tone-3000/nam-pedal/hardware/enclosure/face-drill.pdf

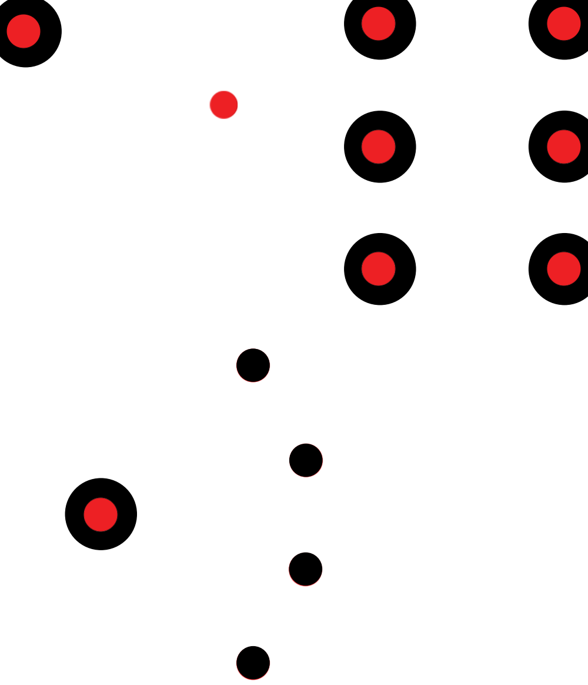
[picture p10: figure]
