tone-3000/nam-pedal/app/src/assets/pedal/bezel-off.webp

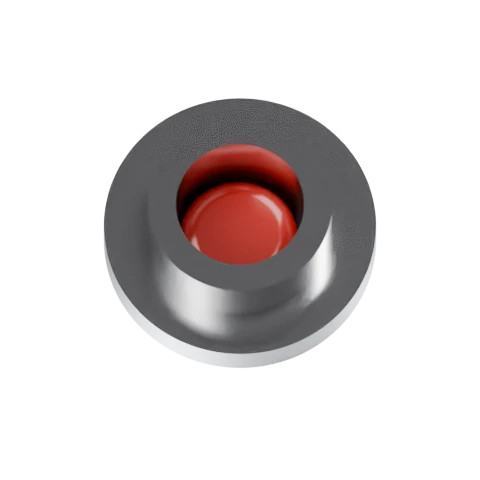
app/src/assets/pedal/bezel-off.webp
