tone-3000/nam-pedal/app/src/assets/pedal/bezel-on.webp

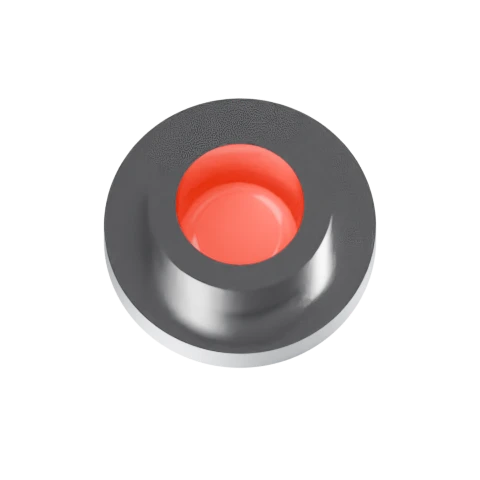
app/src/assets/pedal/bezel-on.webp
