tone-3000/nam-pedal/app/src/assets/pedal/knob.webp

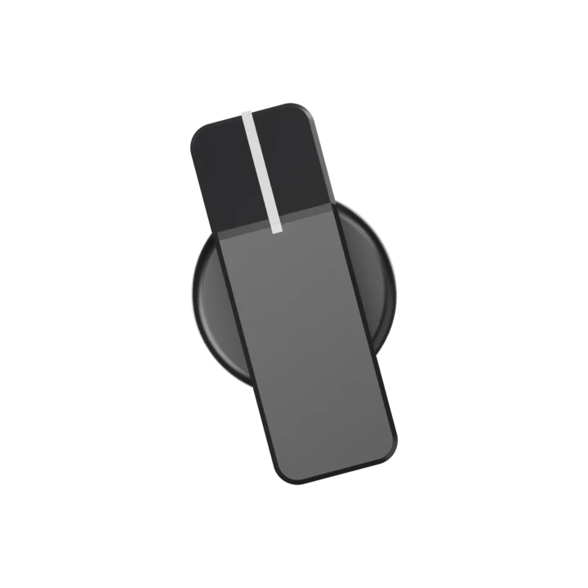
app/src/assets/pedal/knob.webp
