tone-3000/nam-pedal/hardware/enclosure/face-artwork.png

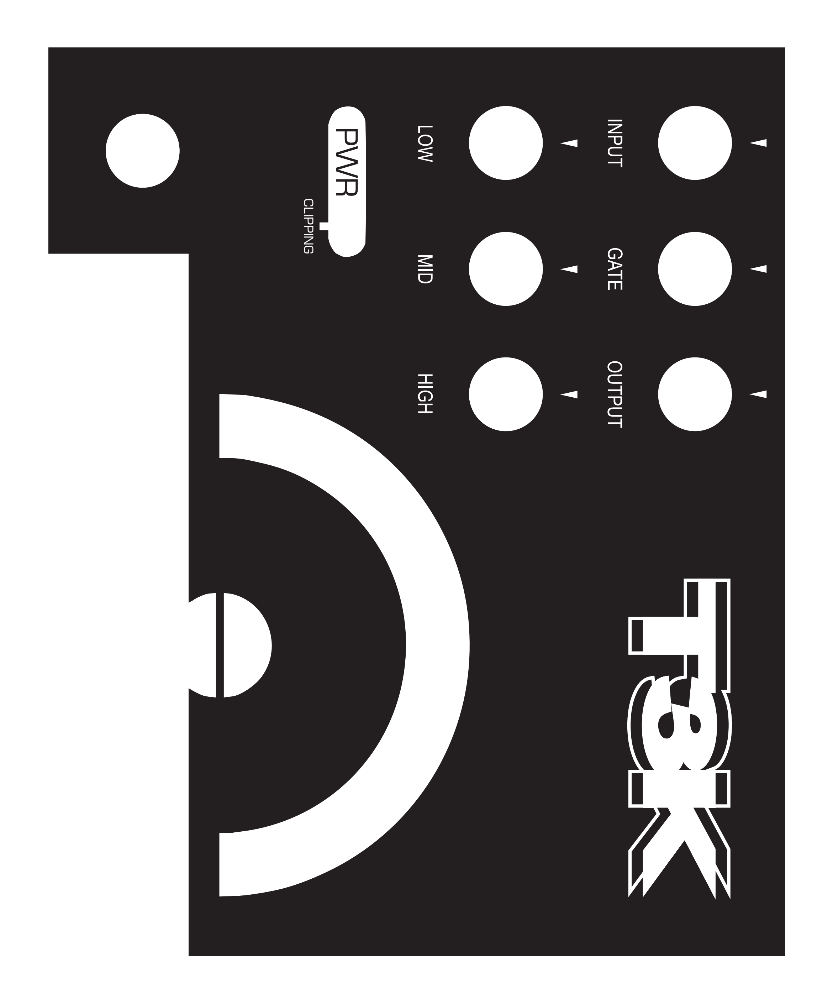
hardware/enclosure/face-artwork.png
