tone-3000/nam-pedal/hardware/enclosure/face-drill.png

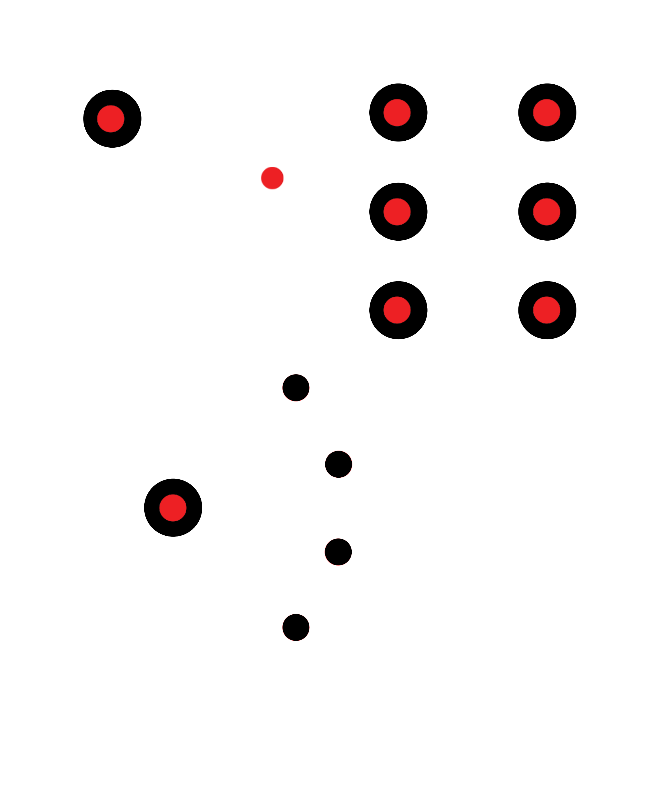
hardware/enclosure/face-drill.png
