tone-3000/nam-pedal/hardware/enclosure/side-wordmark.png

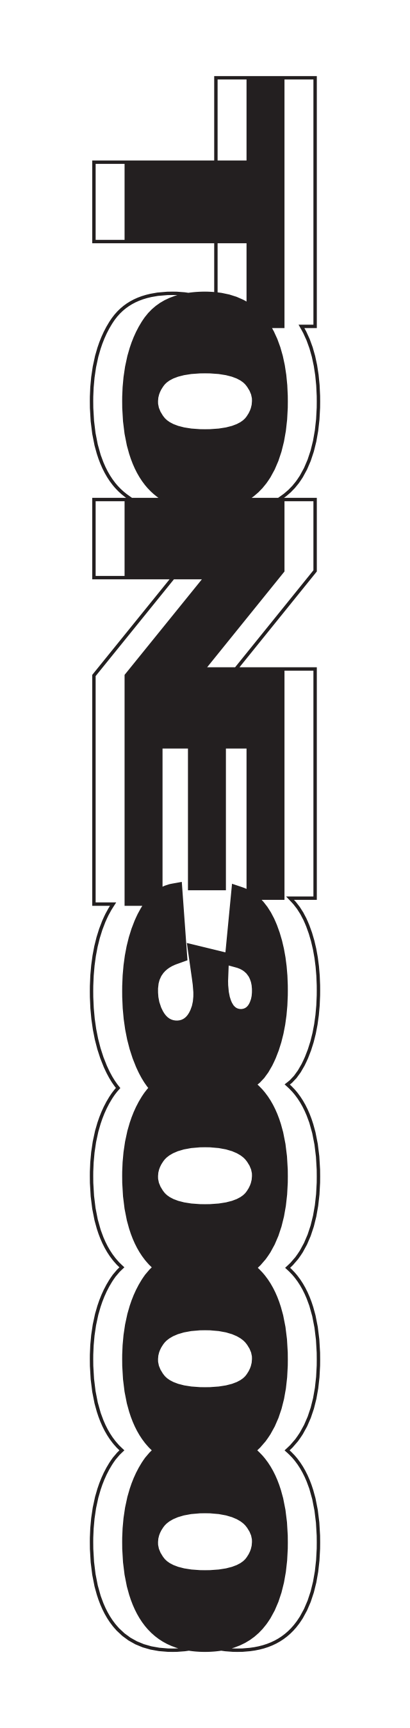
hardware/enclosure/side-wordmark.png
