tone-3000/nam-pedal/hardware/pcb/images/pcb-render-bottom.jpg

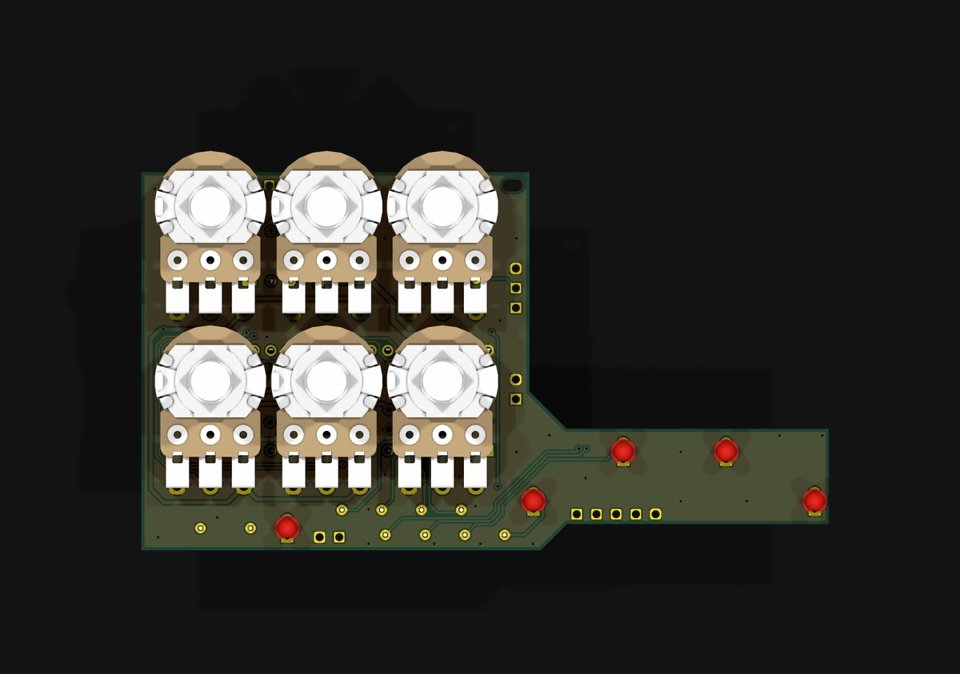
hardware/pcb/images/pcb-render-bottom.jpg
