tone-3000/nam-pedal/hardware/pcb/images/pcb-render-iso.jpg

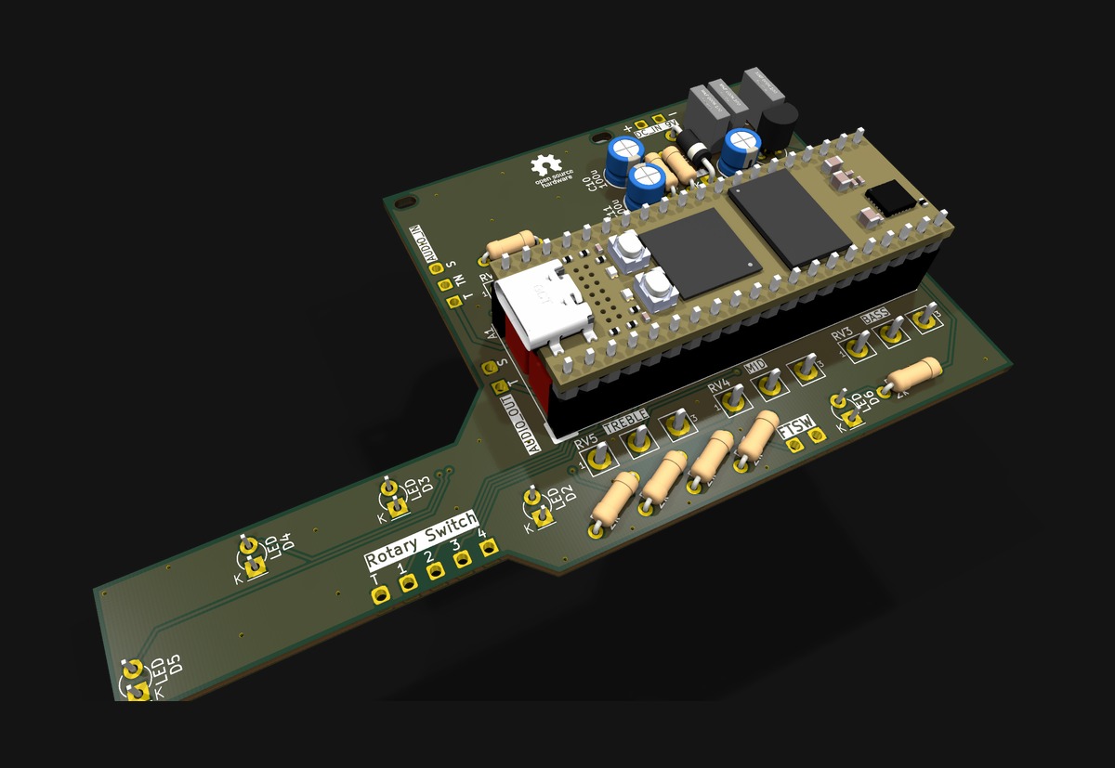
hardware/pcb/images/pcb-render-iso.jpg
