tone-3000/nam-pedal/hardware/pcb/images/pcb-render-top.jpg

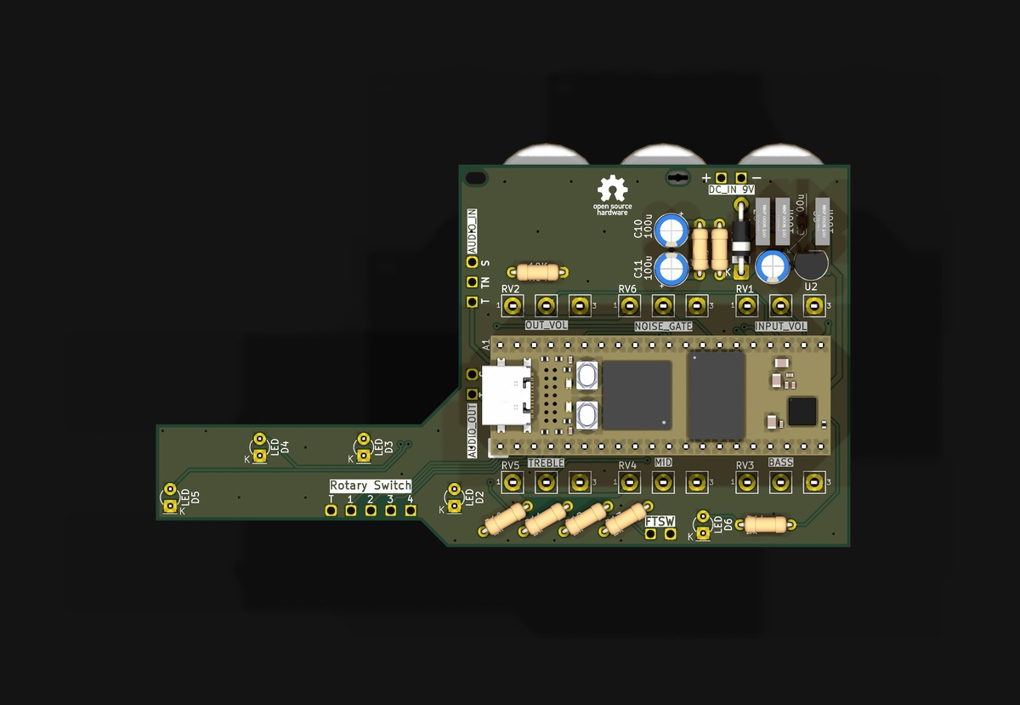
hardware/pcb/images/pcb-render-top.jpg
