tone-3000/nam-pedal/hardware/renders/card-pedal-and-pcb.jpg

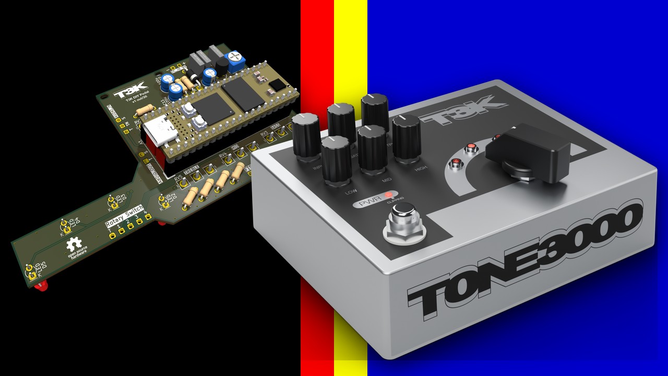
hardware/renders/card-pedal-and-pcb.jpg
