tone-3000/nam-pedal/hardware/renders/pcb-stage-s0-bare.jpg

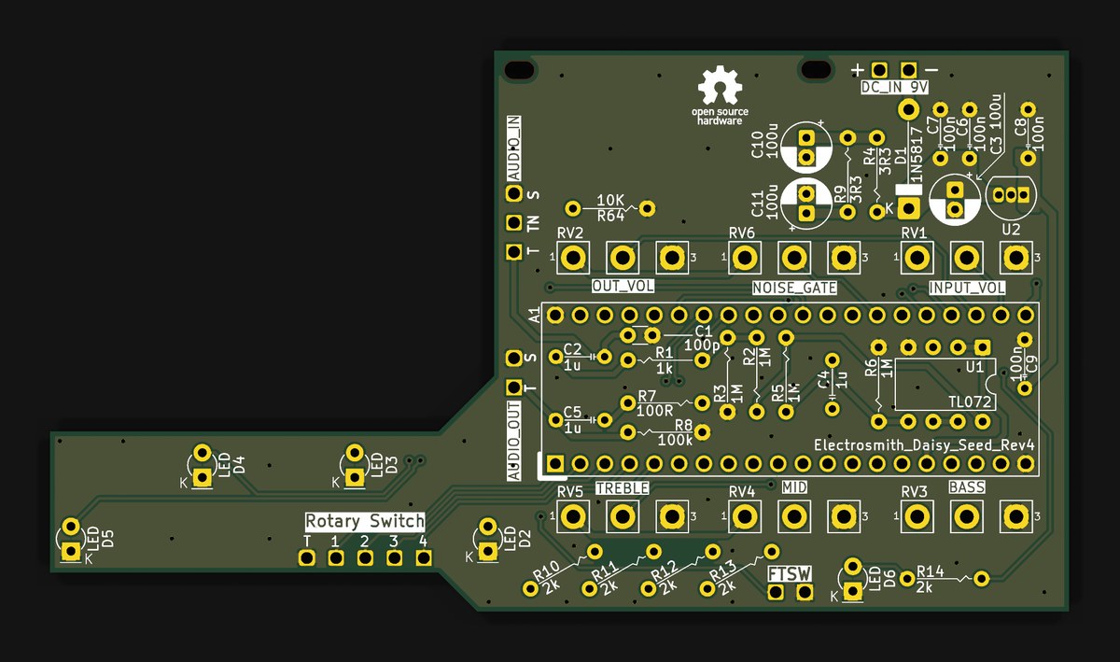
hardware/renders/pcb-stage-s0-bare.jpg
