tone-3000/nam-pedal/hardware/renders/pcb-stage-s1-resistors.jpg

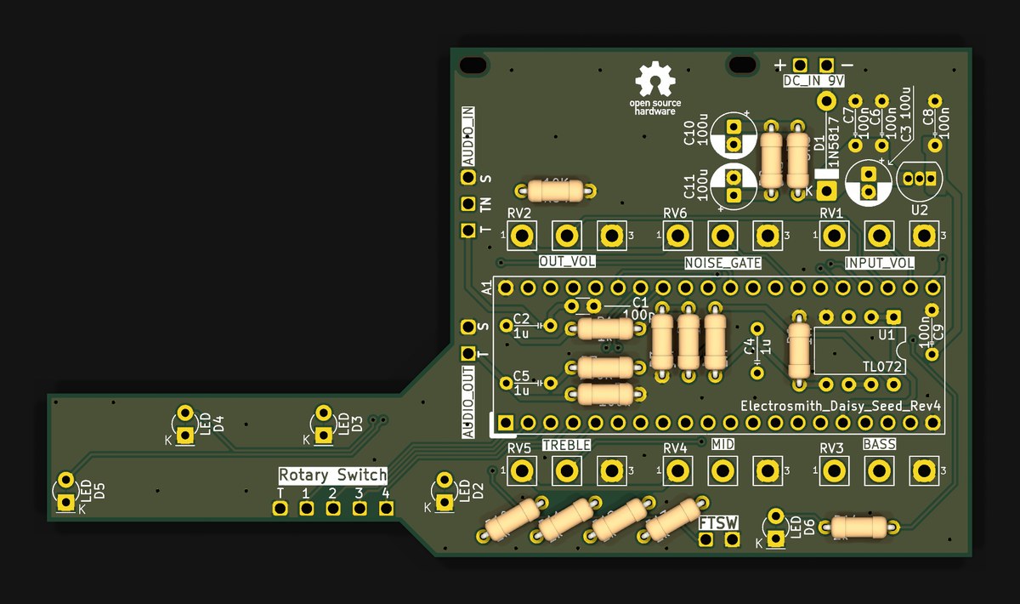
hardware/renders/pcb-stage-s1-resistors.jpg
