tone-3000/nam-pedal/hardware/renders/pcb-stage-s3-caps.jpg

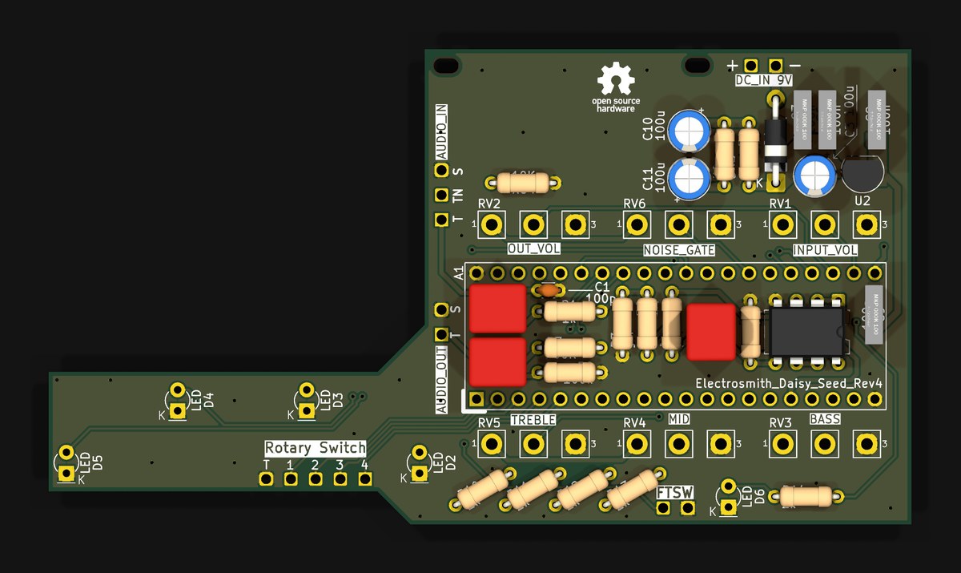
hardware/renders/pcb-stage-s3-caps.jpg
