tone-3000/nam-pedal/hardware/renders/pcb-stage-s5-controls.jpg

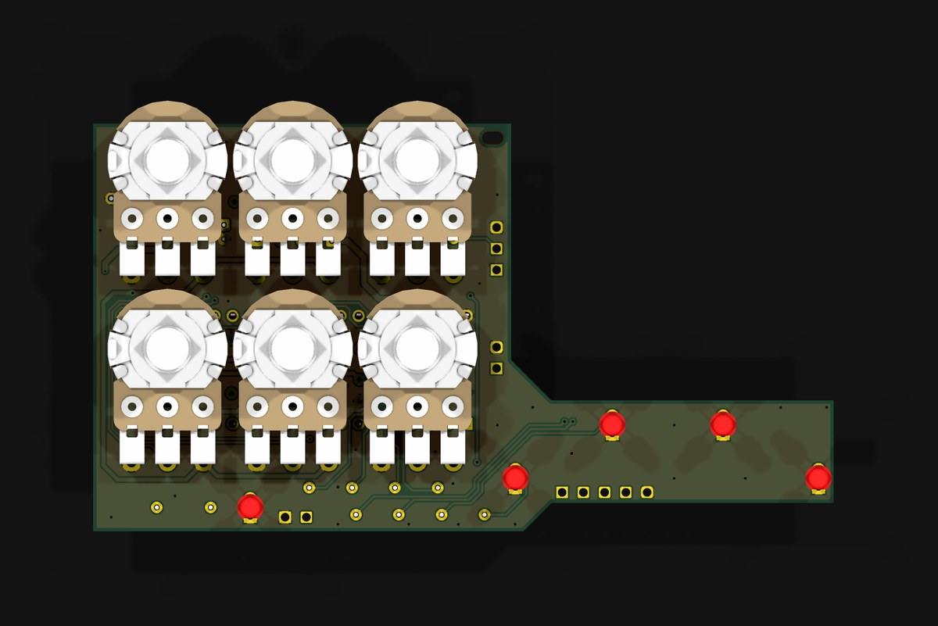
hardware/renders/pcb-stage-s5-controls.jpg
