tone-3000/nam-pedal/hardware/renders/pcb-stage-s6-full-iso.jpg

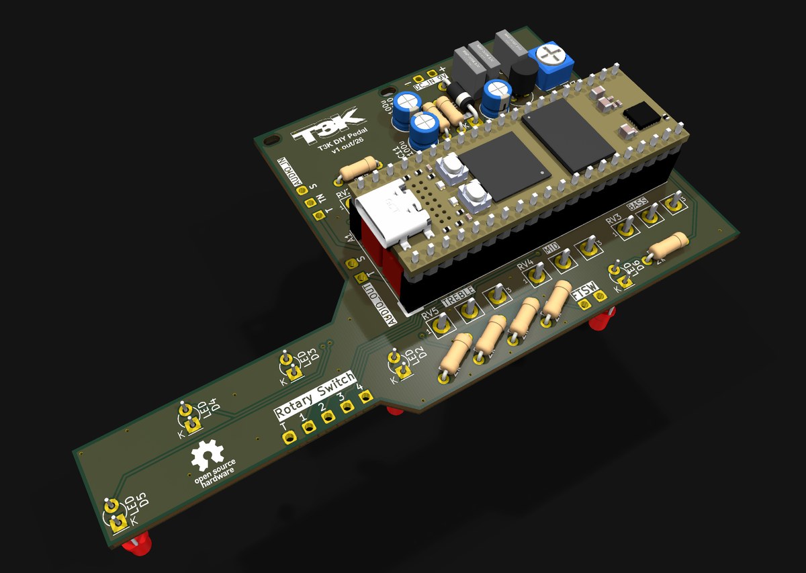
hardware/renders/pcb-stage-s6-full-iso.jpg
