tone-3000/nam-pedal/hardware/renders/pedal-hero.jpg

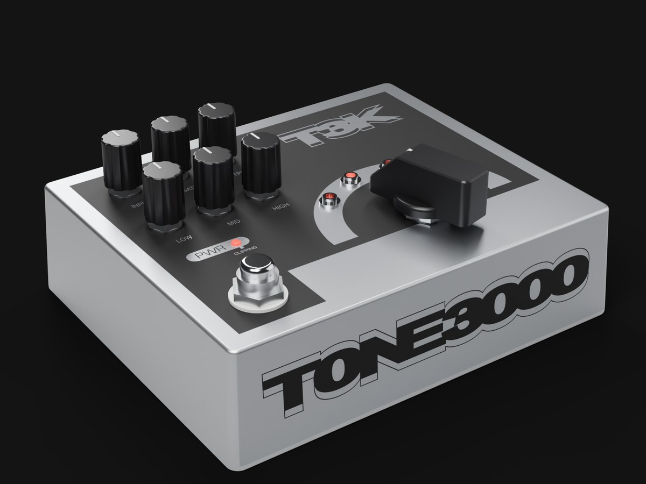
hardware/renders/pedal-hero.jpg
