tone-3000/nam-pedal/hardware/renders/pedal-iso-2.jpg

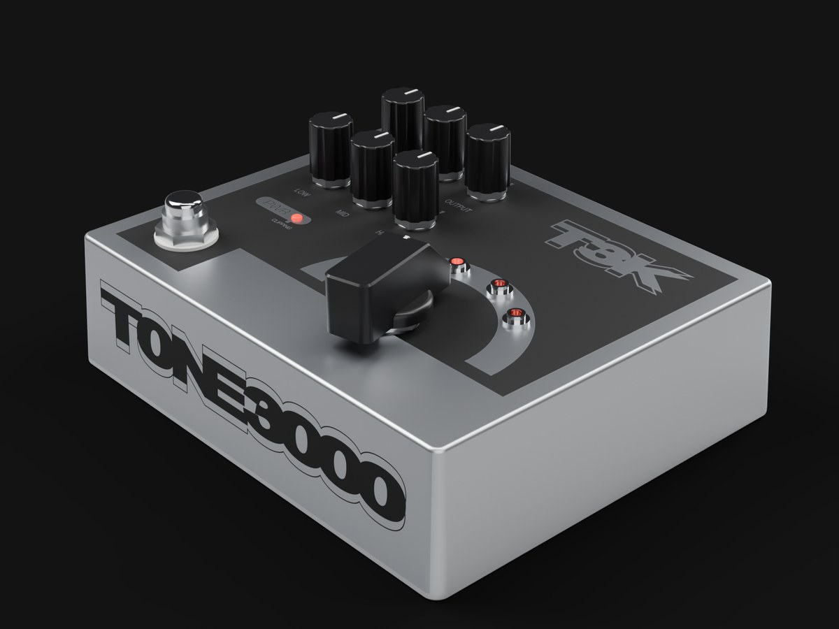
hardware/renders/pedal-iso-2.jpg
