tone-3000/nam-pedal/hardware/renders/src/textures/face_base.png

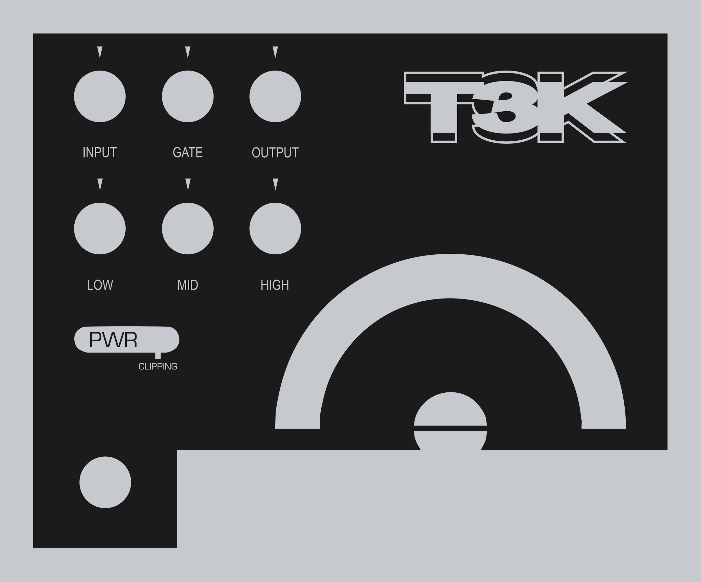
hardware/renders/src/textures/face_base.png
