tone-3000/nam-pedal/hardware/renders/src/textures/face_mr.png

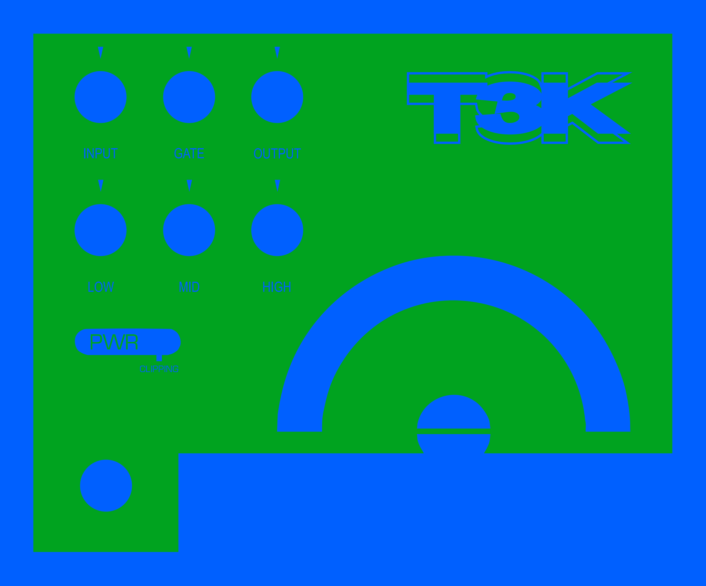
hardware/renders/src/textures/face_mr.png
