tone-3000/nam-pedal/hardware/renders/src/textures/side_base.png

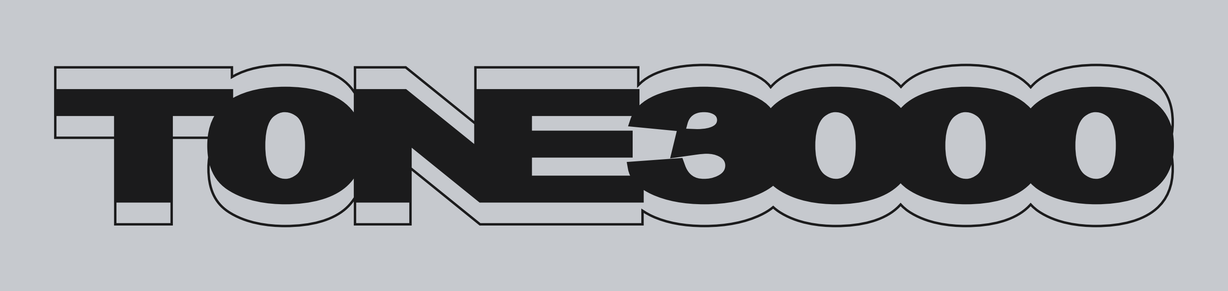
hardware/renders/src/textures/side_base.png
