tone-3000/nam-pedal/hardware/renders/src/textures/side_mr.png

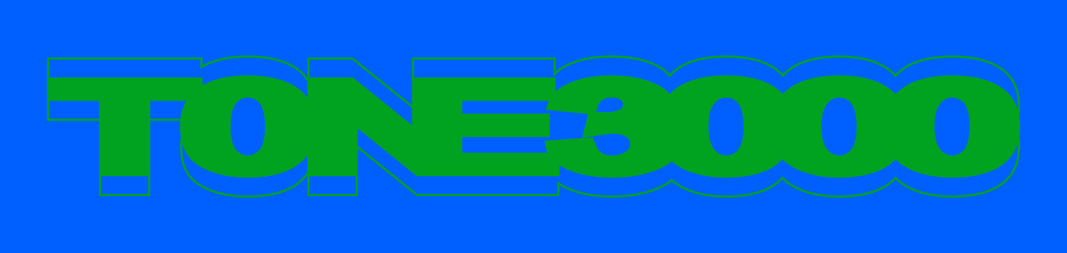
hardware/renders/src/textures/side_mr.png
