tone-3000/nam-pedal/hardware/pcb/bom-kicad.csv

Reference | Value | Footprint | Qty
A1 | Electrosmith_Daisy_Seed_Rev4 | Module:Electrosmith_Daisy_Seed | 1
C1 | 100p | Capacitor_THT:C_Disc_D3.0mm_W1.6mm_P2.50mm | 1
C2,C4,C5 | 1u | Capacitor_THT:C_Rect_L7.2mm_W6.0mm_P5.00mm | 3
C3,C10,C11 | 100u | Capacitor_THT:CP_Radial_D5.0mm_P2.00mm | 3
C6-C9 | 100n | Capacitor_THT:C_Rect_L7.2mm_W2.5mm_P5.00mm | 4
D1 | 1N5817 | Diode_THT:D_DO-41_SOD81_P10.16mm_Horizontal | 1
D2-D6 | LED | LED_THT:LED_D3.0mm_reverse | 5
J2 | JACK_TRS_SWITCHING | Connector_Audio:3T 6.35mm 14 Stereo Chassis Socket | 1
J3 | JACK_TRS_SWITCHING | Connector_Audio:2T 6.35mm 14 Stereo Chassis Socket | 1
J8 | Barrel_Jack_Switch | Connector_Pin:2 Pin DC Jack Chassis mount connector | 1
R1 | 1k | Resistor_THT:R_Axial_DIN0207_L6.3mm_D2.5mm_P7.62mm_Horizontal | 1
R2,R3,R5,R6 | 1M | Resistor_THT:R_Axial_DIN0207_L6.3mm_D2.5mm_P7.62mm_Horizontal | 4
R4,R9 | 3R3 | Resistor_THT:R_Axial_DIN0207_L6.3mm_D2.5mm_P7.62mm_Horizontal | 2
R7 | 100R | Resistor_THT:R_Axial_DIN0207_L6.3mm_D2.5mm_P7.62mm_Horizontal | 1
R8 | 100k | Resistor_THT:R_Axial_DIN0207_L6.3mm_D2.5mm_P7.62mm_Horizontal | 1
R10-R14 | 2k | Resistor_THT:R_Axial_DIN0207_L6.3mm_D2.5mm_P7.62mm_Horizontal | 5
R64 | 10K | Resistor_THT:R_Axial_DIN0207_L6.3mm_D2.5mm_P7.62mm_Horizontal | 1
RV1-RV6 | B10k | Library:POT_16MM | 6
RV7 | 10k | Potentiometer_THT:Potentiometer_Runtron_RM-065_Vertical | 1
SW1 | SW_Rotary_1x4_MP | Connector_Pin:Rotary Switch 3 Pole 4 Position ALPHA SR2511F | 1
SW2 | SW_Push_SPDT | Connector_Pin:2 Pin FTSW | 1
U1 | TL072 | Package_DIP:DIP-8_W7.62mm | 1
U2 | LM78L05_TO92 | Package_TO_SOT_THT:TO-92_Inline | 1
