tone-3000/nam-pedal/hardware/pcb/3d-models/header_2.54_female.stp

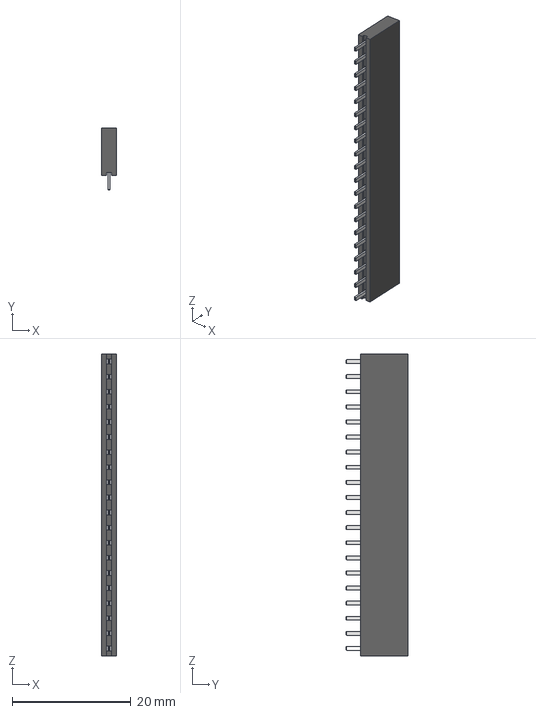
[picture p32: CAD file, 2026-10-20]
hardware/pcb/3d-models/header_2.54_female.stp
2.50 x 10.5 x 50.8 mm
