tone-3000/nam-pedal/hardware/pcb/3d-models/LED_D3.0mm_FlatTop_Standoff10.step

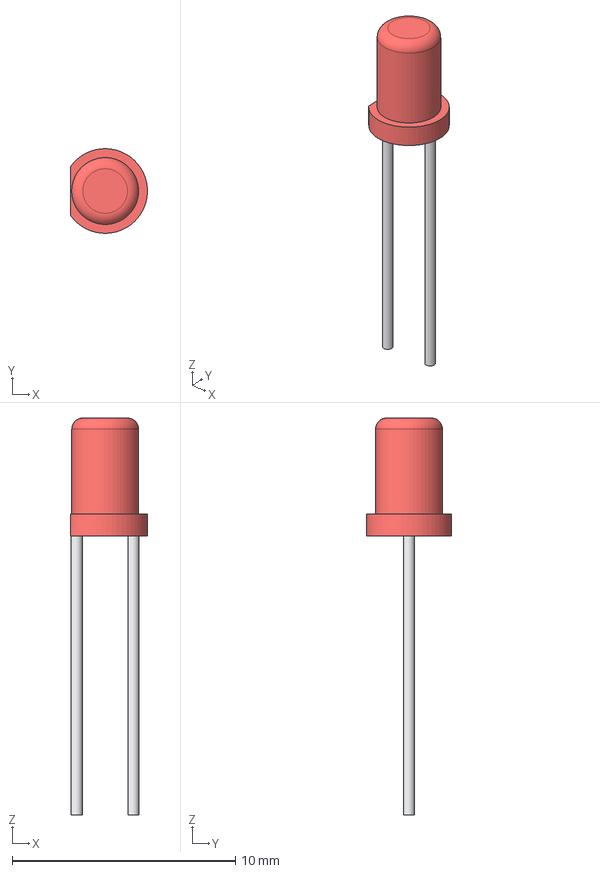
[picture p33: CAD file, 2026-10-20]
hardware/pcb/3d-models/LED_D3.0mm_FlatTop_Standoff10.step
3.45 x 3.80 x 17.8 mm
lens
legs
