tone-3000/nam-pedal/hardware/pcb/3d-models/ES_Daisy_Seed3_Rev5.step

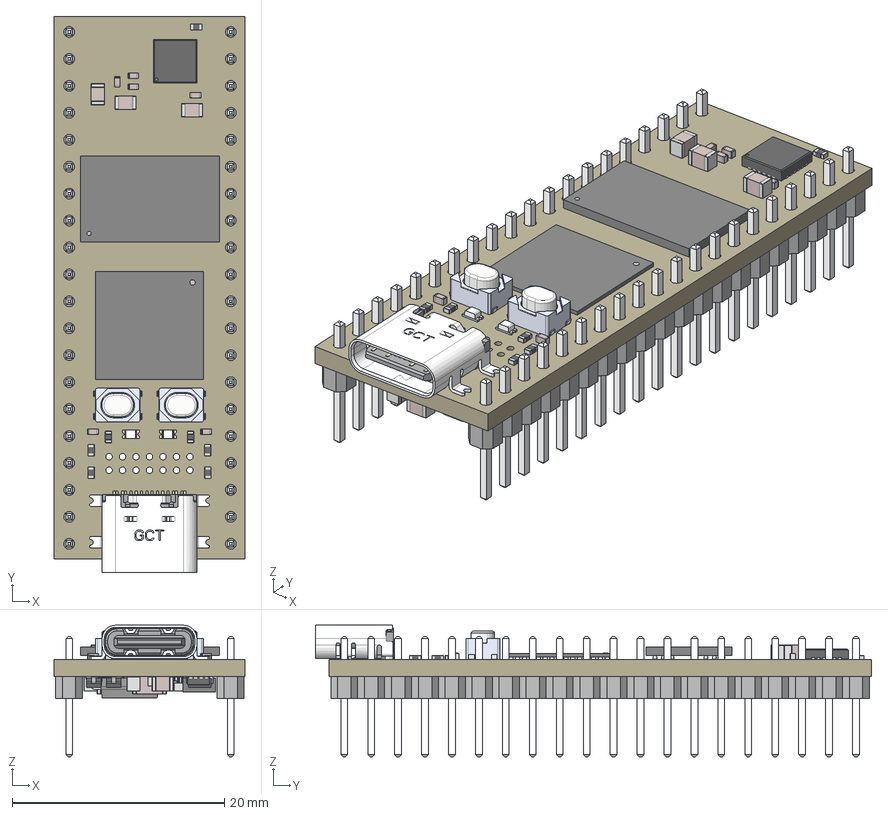
[picture p34: CAD file, 2026-10-20]
hardware/pcb/3d-models/ES_Daisy_Seed3_Rev5.step
18.0 x 52.4 x 12.4 mm
Board
VQFN24_RGE_CORNERPADS_TEX
1X20_NO_SILK_SQR
1X20_NO_SILK
FBGA-90_CLEAN-POL
UFBGA-176_CLEAN-POL
WSON-8-TI
DIODE_0603 x 2
PTS815 x 2
BOURNS_SRP2010
CAPC1005X61N x 46
CAPC2012X137N x 12
CAPC3116X163N x 2
OSCSC320X250X100N
R0402 x 15
YAG-FB-0603-1608
YAG-FB-0603-1608 (1)
SOT23-5
SOD2512X100N x 2
SOT-23-6L
USB4110-GF-A_revB(1) MF
