tone-3000/nam-pedal/hardware/pcb/3d-models/Trimmer_RM-065_Vertical.step

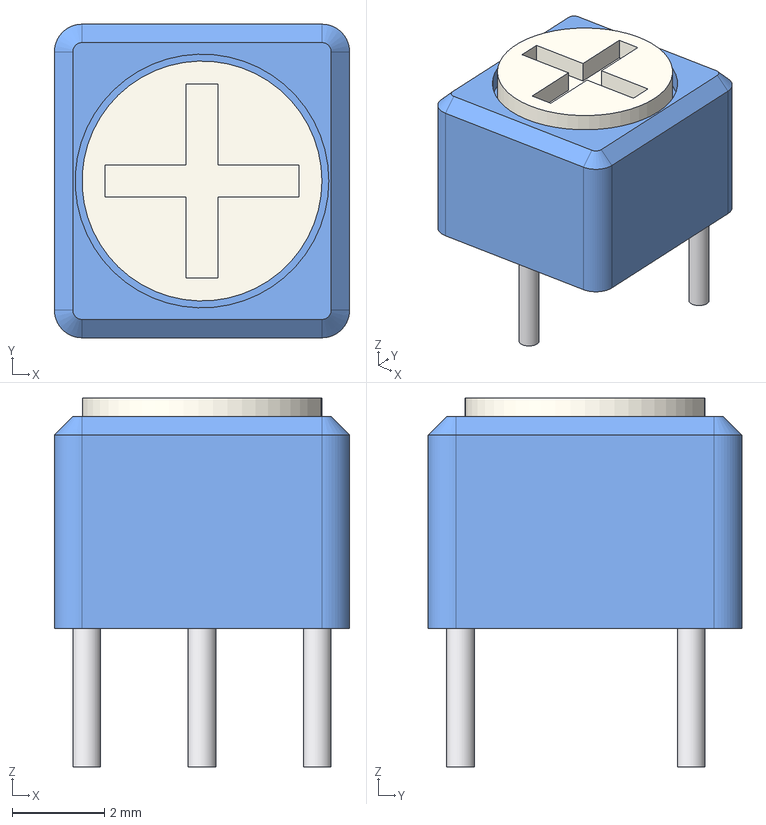
[picture p35: CAD file, 2026-10-20]
hardware/pcb/3d-models/Trimmer_RM-065_Vertical.step
6.40 x 6.80 x 8.00 mm
rotor
legs
