tone-3000/nam-pedal/hardware/pcb/3d-models/RV16AF-41.step

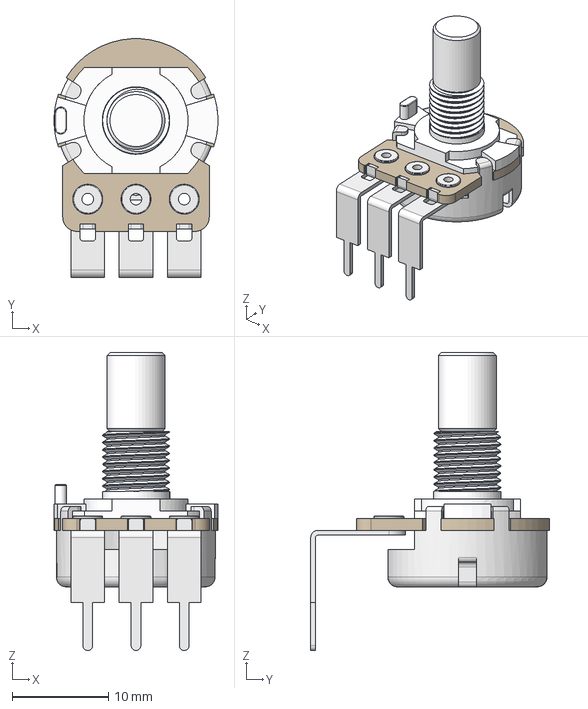
[picture p36: CAD file, 2026-10-20]
hardware/pcb/3d-models/RV16AF-41.step
17.0 x 24.7 x 30.9 mm
