tone-3000/nam-pedal/hardware/pcb/3d-models/User Library-Cap-5 (7_2x6_5x2_2)Dark.step

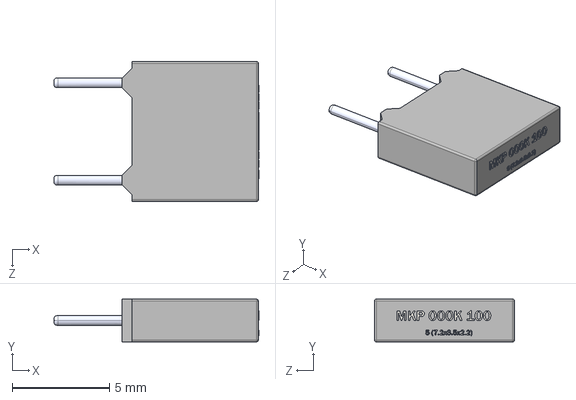
[picture p37: CAD file, 2026-10-20]
hardware/pcb/3d-models/User Library-Cap-5 (7_2x6_5x2_2)Dark.step
10.5 x 2.20 x 7.20 mm
