tone-3000/nam-pedal/hardware/renders/build-06-hardware-top.jpg

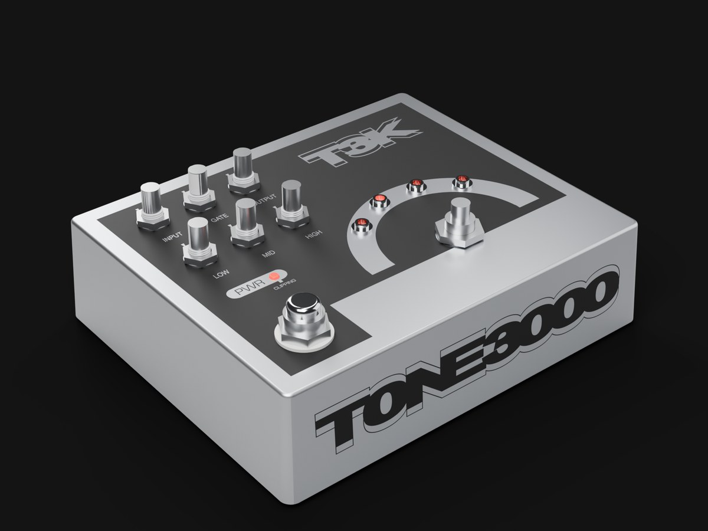
hardware/renders/build-06-hardware-top.jpg
