tone-3000/nam-pedal/hardware/renders/build-07-wiring-jacks.jpg

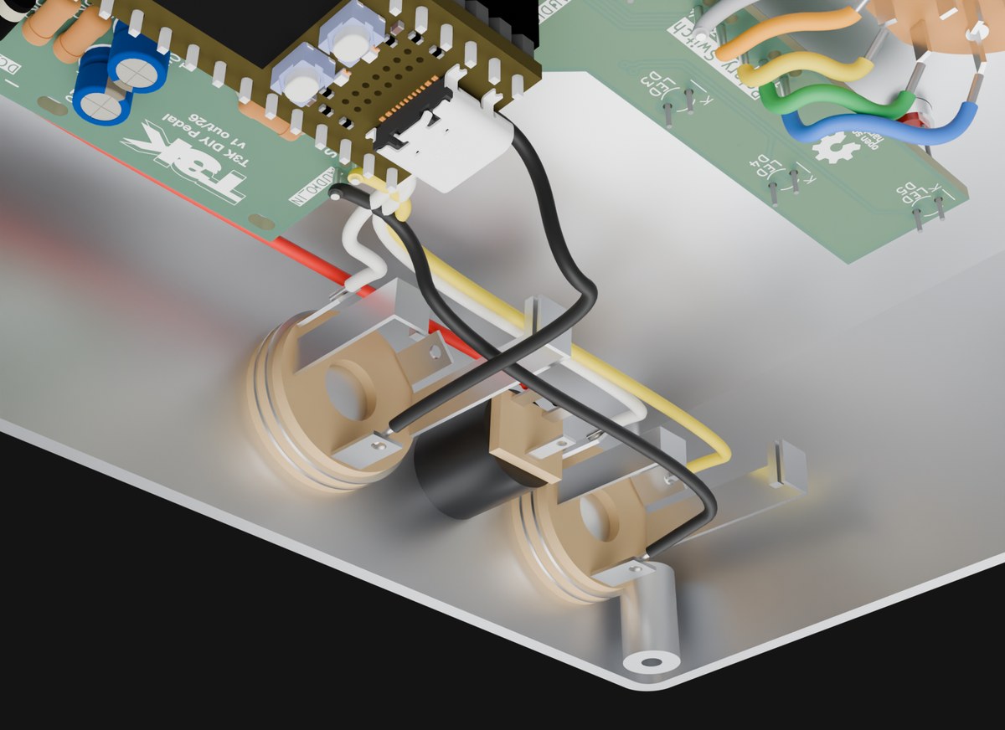
hardware/renders/build-07-wiring-jacks.jpg
