tone-3000/nam-pedal/hardware/renders/build-07-wiring-rotary-footswitch.jpg

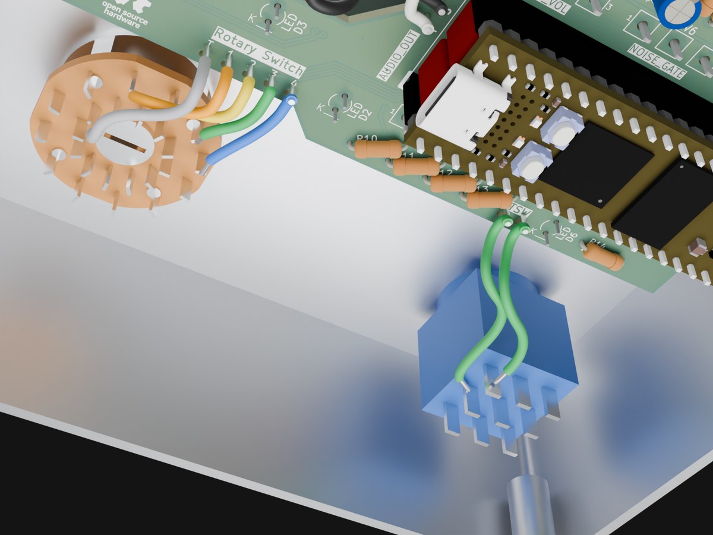
hardware/renders/build-07-wiring-rotary-footswitch.jpg
