tone-3000/nam-pedal/hardware/renders/build-animation-poster.jpg

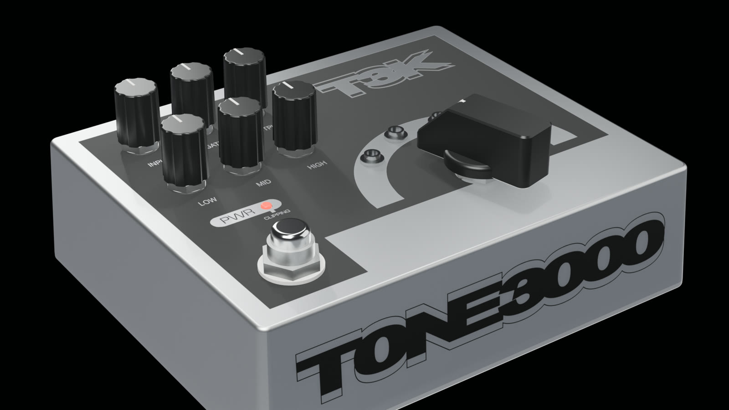
hardware/renders/build-animation-poster.jpg
