tone-3000/nam-pedal/hardware/pcb/schematic.pdf

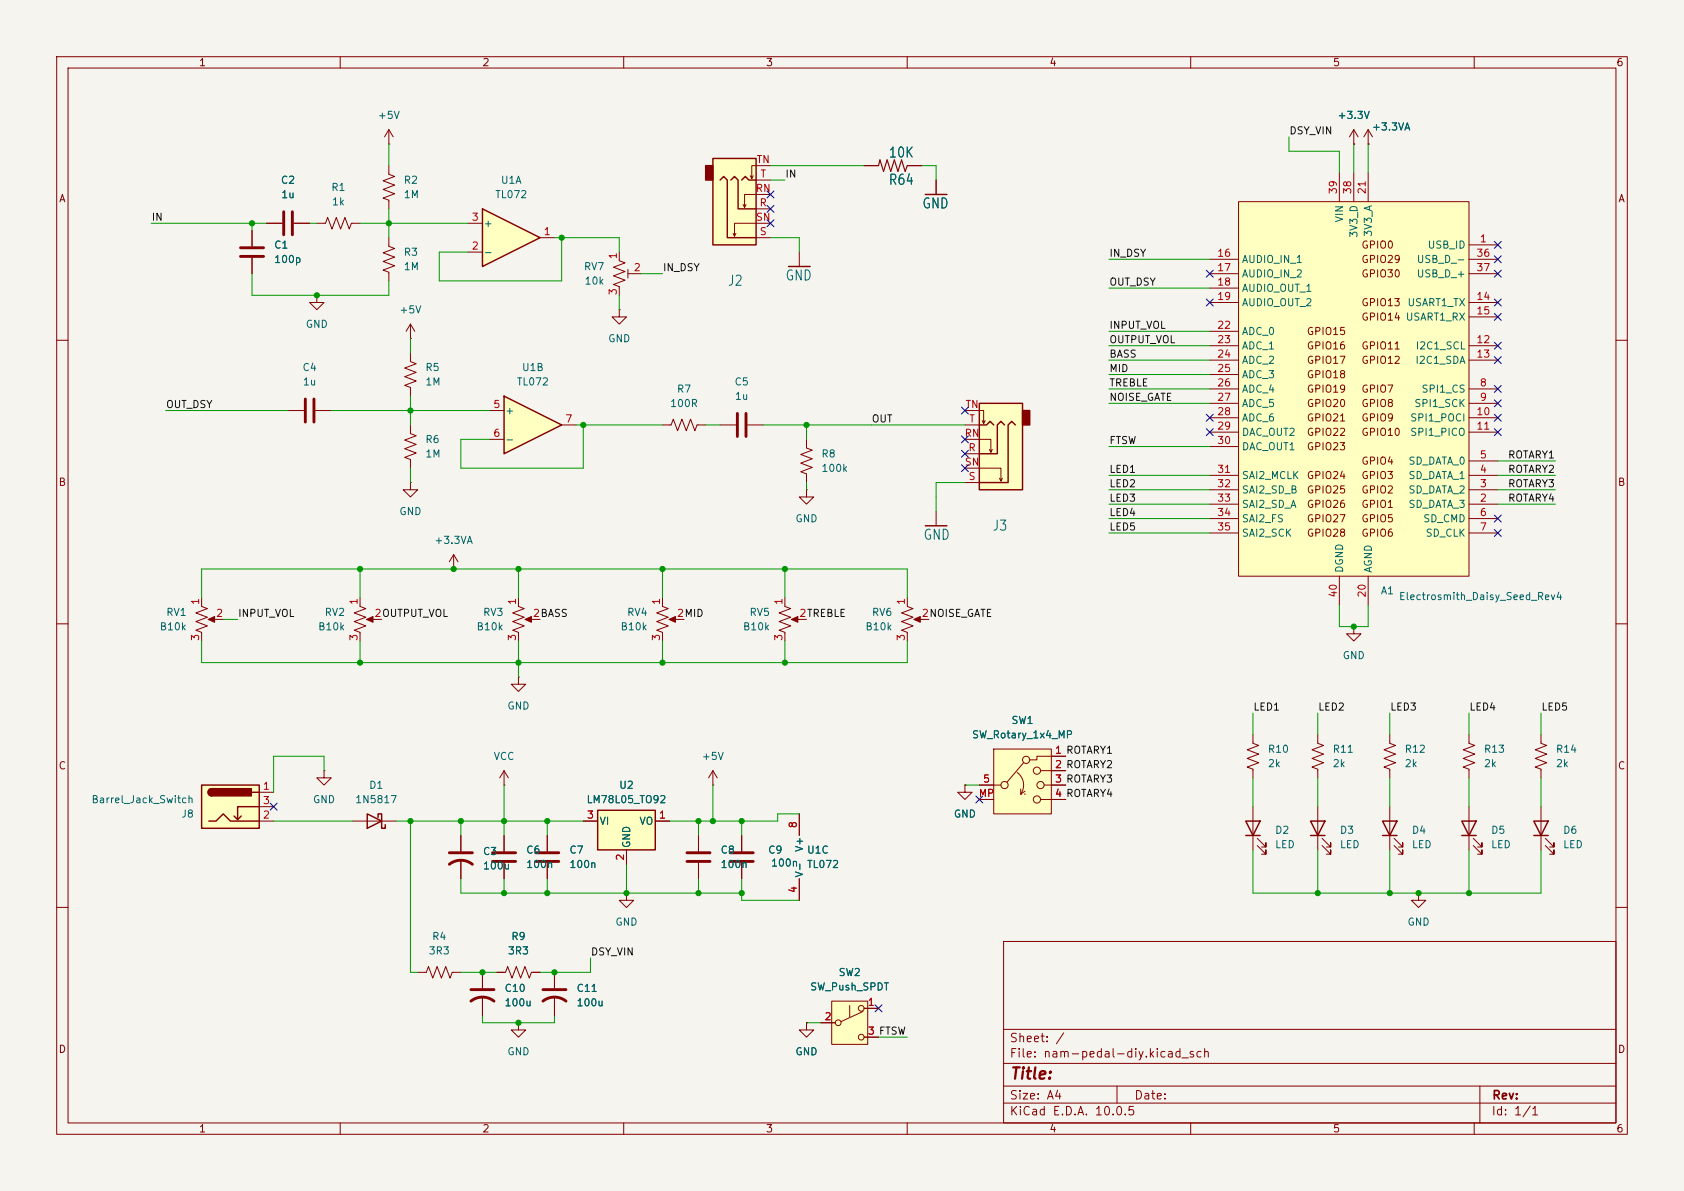
[picture p42: page 1]

Sheet: /
File: nam-pedal-diy.kicad_sch
Title:

Size: A4 | Rev:
KiCad E.D.A. 10.0.5 | Id: 1/1
