tone-3000/nam-pedal/hardware/enclosure/face-artwork.pdf

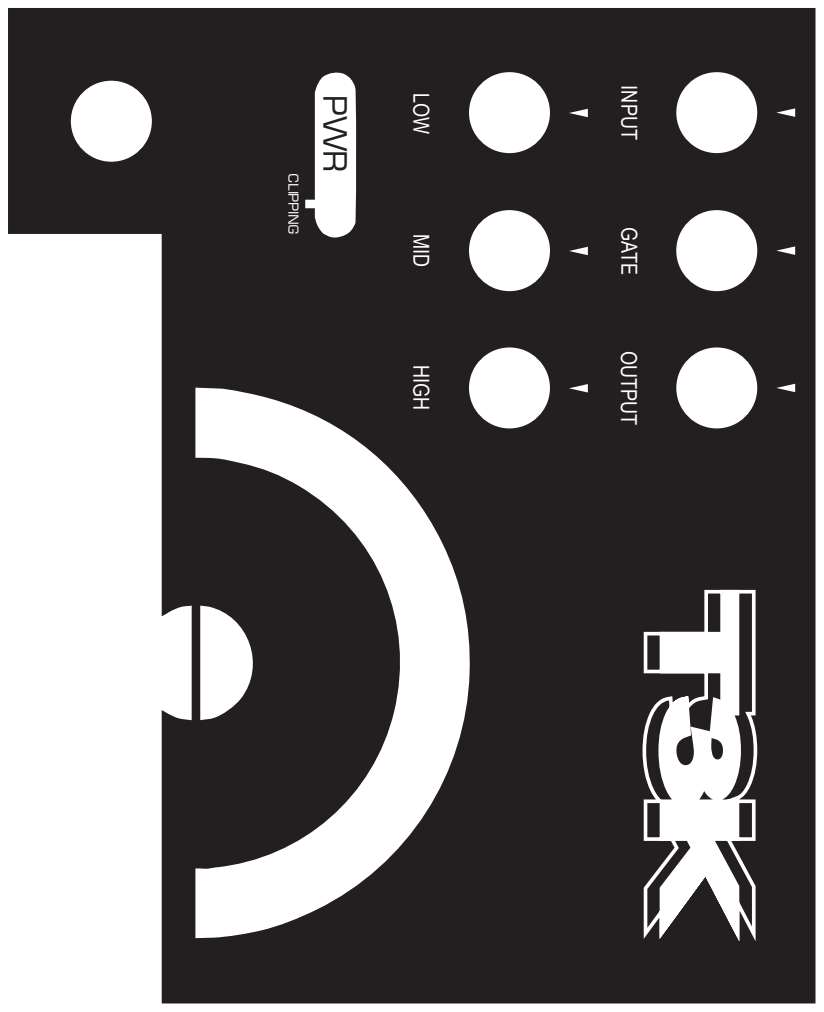
[picture p43: page 1]
PWR; CLIPPING

HIGH MID LOW

OUTPUT GATE INPUT
