tone-3000/nam-pedal/hardware/pcb/nam-pedal-diy.kicad_pcb

## KiCad design hardware/pcb/nam-pedal-diy.kicad_pcb (2026-10-17)

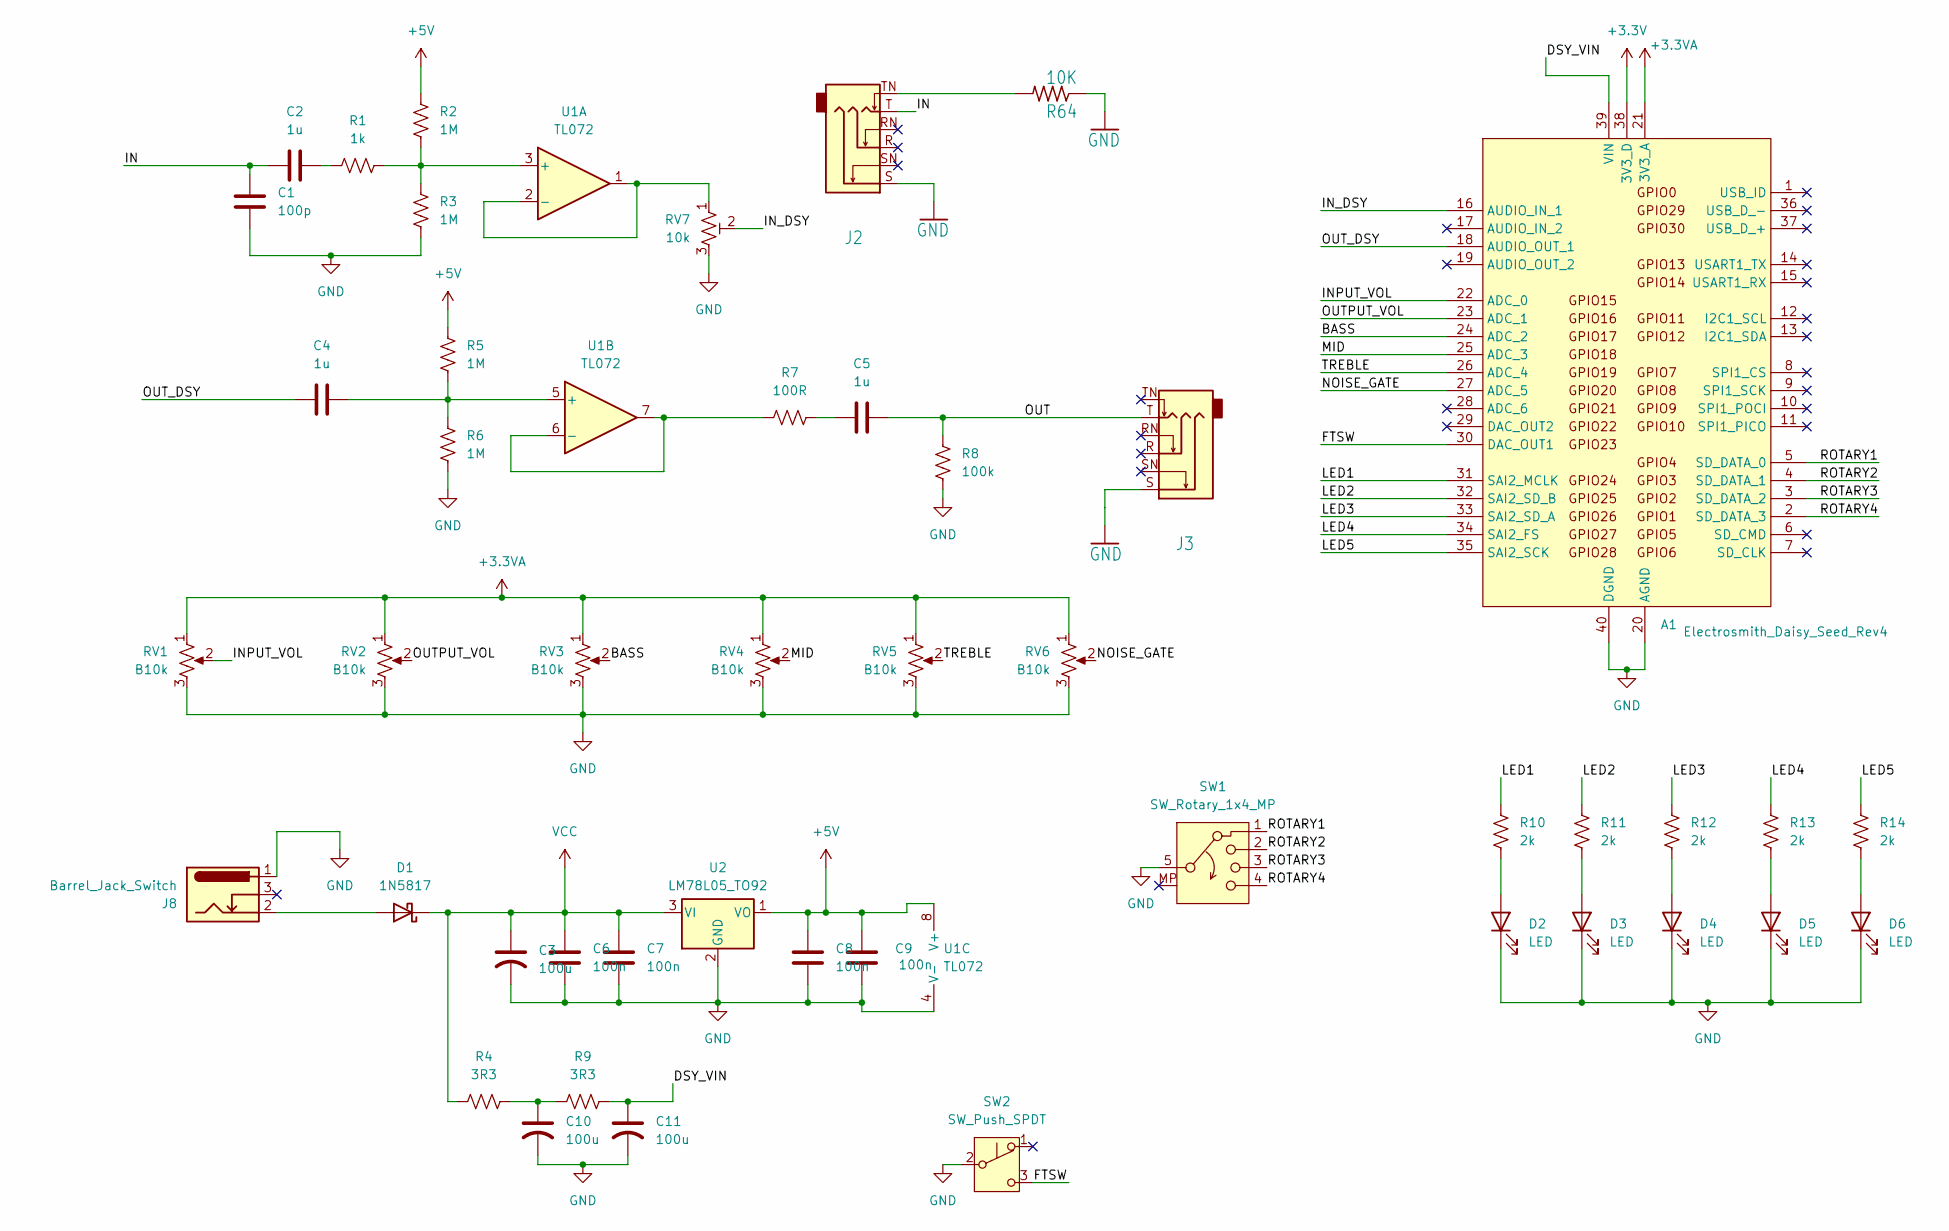
[picture p44: schematic nam-pedal-diy.kicad_sch]

Parts:
A1: Electrosmith_Daisy_Seed_Rev4; Electrosmith_Daisy_Seed
C1: 100p; C_Disc_D3.0mm_W1.6mm_P2.50mm
C2, C4, C5: 1u; C_Rect_L7.2mm_W6.0mm_P5.00mm
C3, C10, C11: 100u; CP_Radial_D5.0mm_P2.00mm
C6, C7, C8, C9: 100n; C_Rect_L7.2mm_W2.5mm_P5.00mm
D1: 1N5817; D_DO-41_SOD81_P10.16mm_Horizontal
D2, D3, D4, D5, D6: LED; LED_D3.0mm_reverse
J2: JACK_TRS_SWITCHING; 3T 6.35mm 14 Stereo Chassis Socket
J3: JACK_TRS_SWITCHING; 2T 6.35mm 14 Stereo Chassis Socket
J8: Barrel_Jack_Switch; 2 Pin DC Jack Chassis mount connector
R1: 1k; R_Axial_DIN0207_L6.3mm_D2.5mm_P7.62mm_Horizontal
R2, R3, R5, R6: 1M; R_Axial_DIN0207_L6.3mm_D2.5mm_P7.62mm_Horizontal
R4, R9: 3R3; R_Axial_DIN0207_L6.3mm_D2.5mm_P7.62mm_Horizontal
R7: 100R; R_Axial_DIN0207_L6.3mm_D2.5mm_P7.62mm_Horizontal
R8: 100k; R_Axial_DIN0207_L6.3mm_D2.5mm_P7.62mm_Horizontal
R10, R11, R12, R13, R14: 2k; R_Axial_DIN0207_L6.3mm_D2.5mm_P7.62mm_Horizontal
R64: 10K; R_Axial_DIN0207_L6.3mm_D2.5mm_P7.62mm_Horizontal
RV1, RV2, RV3, RV4, RV5, RV6: B10k; POT_16MM
RV7: 10k; Potentiometer_Runtron_RM-065_Vertical
SW1: SW_Rotary_1x4_MP; Rotary Switch 3 Pole 4 Position ALPHA SR2511F
SW2: SW_Push_SPDT; 2 Pin FTSW
U1: TL072; DIP-8_W7.62mm
U2: LM78L05_TO92; TO-92_Inline

Connections:
+3.3V: A1.38 (3V3_D)
+3.3VA: A1.21 (3V3_A), RV1.1, RV2.1, RV3.1, RV4.1, RV5.1, RV6.1
+5V: C8.2, C9.2, R2.1, R5.1, U1.8 (V+), U2.1 (VO)
/BASS: A1.24 (ADC_2), RV3.2
/DSY_VIN: A1.39 (VIN), C11.1, R9.2
/FTSW: A1.30 (DAC_OUT1), SW2.3 (C)
/IN: C1.1, C2.1, J2.T
/INPUT_VOL: A1.22 (ADC_0), RV1.2
/IN_DSY: A1.16 (AUDIO_IN_1), RV7.2
/LED1: A1.31 (SAI2_MCLK), R10.1
/LED2: A1.32 (SAI2_SD_B), R11.1
/LED3: A1.33 (SAI2_SD_A), R12.1
/LED4: A1.34 (SAI2_FS), R13.1
/LED5: A1.35 (SAI2_SCK), R14.1
/MID: A1.25 (ADC_3), RV4.2
/NOISE_GATE: A1.27 (ADC_5), RV6.2
/OUT: C5.2, J3.T, R8.1
/OUTPUT_VOL: A1.23 (ADC_1), RV2.2
/OUT_DSY: A1.18 (AUDIO_OUT_1), C4.1
/ROTARY1: A1.5 (SD_DATA_0), SW1.1
/ROTARY2: A1.4 (SD_DATA_1), SW1.2
/ROTARY3: A1.3 (SD_DATA_2), SW1.3
/ROTARY4: A1.2 (SD_DATA_3), SW1.4
/TREBLE: A1.26 (ADC_4), RV5.2
GND: A1.20 (AGND), A1.40 (DGND), C1.2, C3.2, C6.1, C7.1, C8.1, C9.1, C10.2, C11.2, D2.1 (K), D3.1 (K), D4.1 (K), D5.1 (K), D6.1 (K), J2.S, J3.S, J8.1, R3.2, R6.2, R8.2, R64.1, RV1.3, RV2.3, RV3.3, RV4.3, RV5.3, RV6.3, RV7.3, SW1.5, SW2.2 (B), U1.4 (V-), U2.2 (GND)
unnamed: C2.2, R1.1
unnamed: C5.1, R7.2
unnamed: C10.1, R4.2, R9.1
unnamed: D1.2 (A), J8.2
unnamed: D2.2 (A), R10.2
unnamed: D3.2 (A), R11.2
unnamed: D4.2 (A), R12.2
unnamed: D5.2 (A), R13.2
unnamed: D6.2 (A), R14.2
unnamed: J2.TN, R64.2
unnamed: R1.2, R2.2, R3.1, U1.3 (+)
unnamed: RV7.1, U1.1, U1.2 (-)
unnamed: C4.2, R5.2, R6.1, U1.5 (+)
unnamed: R7.1, U1.6 (-), U1.7
VCC: C3.1, C6.2, C7.2, D1.1 (K), R4.1, U2.3 (VI)

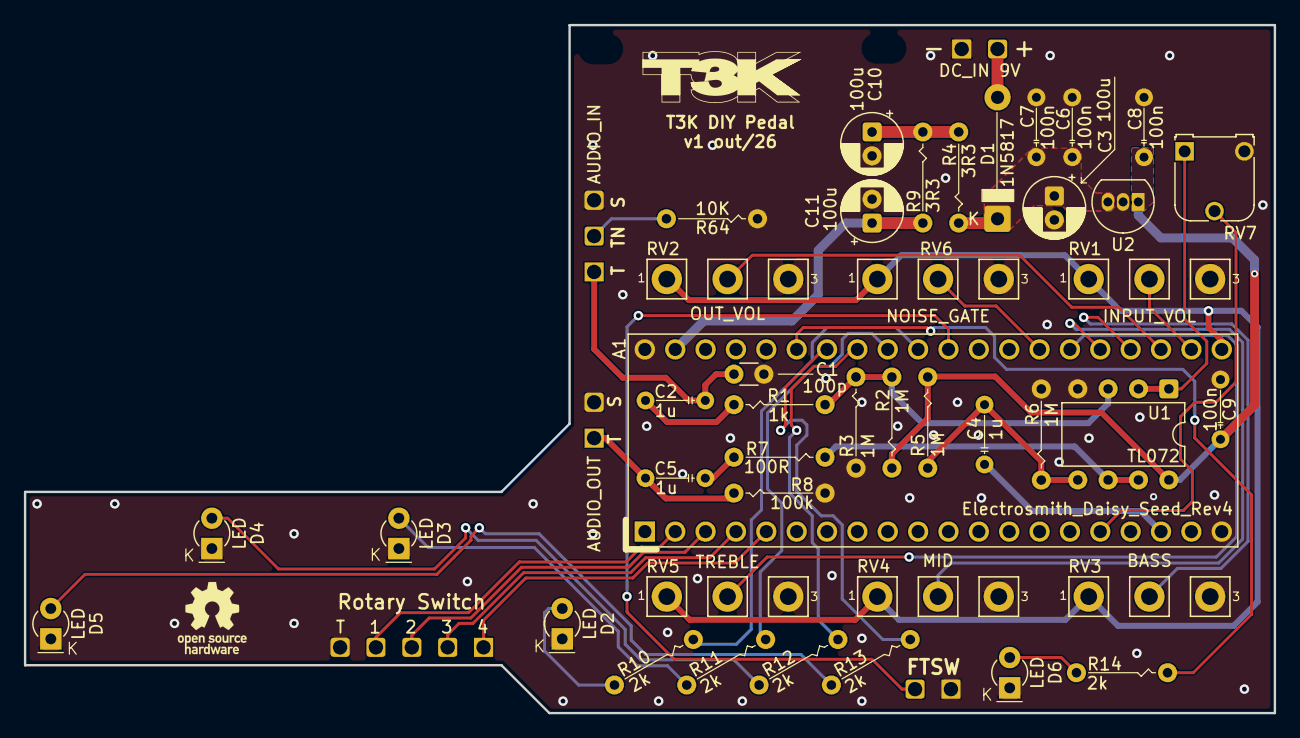
[picture p45: board nam-pedal-diy.kicad_pcb from above]

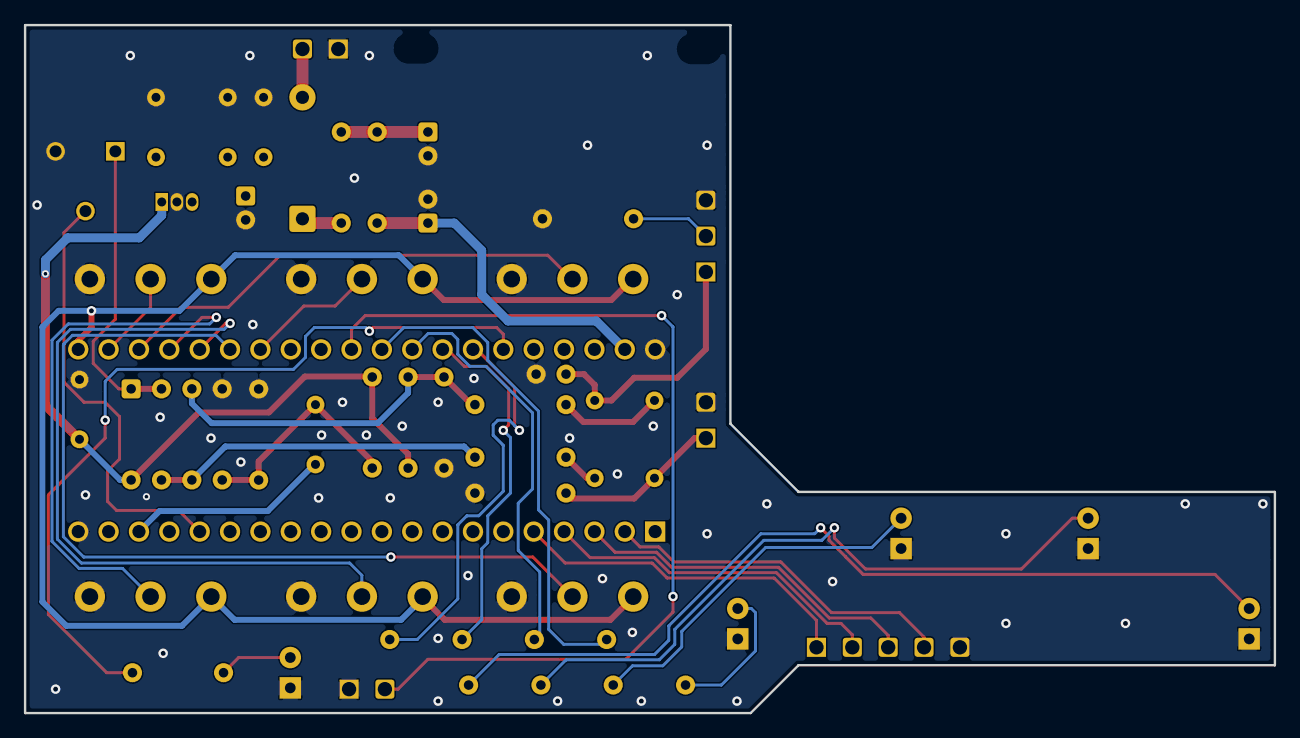
[picture p46: board nam-pedal-diy.kicad_pcb from below]

Board: 4 copper layers, 104.5 x 57.6 mm, 47 parts (6 on the bottom side), 39 nets.
