tone-3000/nam-pedal/pack_models.py

#!/usr/bin/env python3
"""
pack_models.py — pack presets for the TONE3000 × Daisy DIY Pedal (T3K Pedal)
into a bank image.  Command-line counterpart of the companion app (app/).

The bank is written to a fixed QSPI flash region (default 0x90600000),
completely independent of the firmware binary.  Presets can be swapped by
reflashing only the bank; the firmware image is never touched.

Each preset is one or two blocks:
  block 1  an A2-Lite NAM capture
  block 2  another A2-Lite capture (e.g. a pedal into an amp), or a cab IR

Usage:
  pack_models.py [options] NAME:NAM[:NAM2|IR] [NAME:NAM[:NAM2|IR] ...]

  NAME   display name stored in the bank (max 31 chars)
  NAM    path to a .namb file, or a .nam file (plain WaveNet or
         SlimmableContainer — converted automatically via nam2namb)
  NAM2   optional second capture (.nam / .namb), run after the first
  IR     optional cabinet IR WAV file instead of NAM2
         (PCM 16/24/32-bit or IEEE float 32-bit, mono or multi-channel)
         Only channel 0 is used.  IR is truncated to MAX_IR_TAPS samples
         (4096 taps ≈ 85 ms @ 48 kHz).

  A file may carry its TONE3000 model id as `path@ID` (e.g. amp.nam@476289).
  The id is stored in the bank so the companion app's "Sync from pedal" can
  find the tone again; it is otherwise unused.

Options:
  -o FILE       Output file (default: model_bank.bin)
  --slim FLOAT  Slim factor for SlimmableContainer .nam files (default: 0.0).
                Selects the first submodel whose max_value > FLOAT, giving
                the smallest model (A2-Lite) for values near 0.
  --flash       Flash the bank to a connected Daisy (requires: pip install pyusb)
  --port PORT   Serial port of the running pedal (e.g. /dev/tty.usbmodemXXXX).
                When given, sends a DFU trigger byte over USB CDC so the pedal
                resets into DFU mode automatically before flashing.
                Without --port the Daisy must already be in DFU mode.
  --addr ADDR   Target flash address in hex (default: 0x90600000)
  --list FILE   List presets stored in an existing bank file and exit
  --dump        Ask the running pedal (--port) for its bank directory and exit.
                Same data the app's "Sync from pedal" reads: names, block
                kinds and TONE3000 model ids.  Needs firmware with the 'B'
                serial command.

Requires the Daisy bootloader (BOOT_QSPI firmware target).
Flashing uses pydfu.py (MIT) vendored alongside this script.
--port requires pyserial (pip install pyserial).

Examples:
  pack_models.py --flash --port /dev/tty.usbmodem0001 "TonePlier:tone_plier.nam:mesa_cab.wav"
  pack_models.py "Amp1:model1.nam" "Amp2:model2.nam:cab.wav" "OD > Amp:od808.nam:amp.nam"
  pack_models.py -o bank.bin Fender:clean.namb:twin_reverb.wav
  pack_models.py "Plexi:plexi.nam@476289:cab.wav@12345"
  pack_models.py --list model_bank.bin
  pack_models.py --dump --port /dev/tty.usbmodem0001
"""

import argparse
import math
import os
import struct
import subprocess
import sys
import tempfile
import time

BANK_MAGIC   = 0x504D414E  # "NAMP"
BANK_VERSION = 2
HEADER_SIZE  = 64          # bytes
ENTRY_SIZE   = 64          # name(32) + nam offset/size + nam2 offset/size + ir offset/num_samples + 2 model ids
NAMB_MAGIC   = 0x4E414D42  # "NAMB"
MAX_IR_TAPS  = 4096        # must match kMaxIrLen in t3k_pedal.cpp


# ── WAV reader ────────────────────────────────────────────────────────────

def _s24_le(data, offset):
    v = data[offset] | (data[offset + 1] << 8) | (data[offset + 2] << 16)
    return v - 0x1000000 if v >= 0x800000 else v


def read_wav_mono_f32(path):
    """Return (samples: list[float], sample_rate: int) from a WAV file.

    Supports PCM 16/24/32-bit and IEEE float 32-bit.  Multi-channel files are
    reduced to mono by taking channel 0 only.  Samples are normalised to [-1, 1].
    """
    try:
        raw = open(path, 'rb').read()
    except OSError as e:
        sys.exit(f'error: {e}')

    if raw[:4] != b'RIFF' or raw[8:12] != b'WAVE':
        sys.exit(f'error: {path}: not a WAV file')

    fmt_chunk = data_chunk = None
    pos = 12
    while pos + 8 <= len(raw):
        tag  = raw[pos:pos + 4]
        clen = struct.unpack_from('<I', raw, pos + 4)[0]
        body = raw[pos + 8: pos + 8 + clen]
        if tag == b'fmt ':
            fmt_chunk = body
        elif tag == b'data':
            data_chunk = body
        pos += 8 + clen + (clen & 1)  # word-align per RIFF spec

    if fmt_chunk is None or data_chunk is None:
        sys.exit(f'error: {path}: missing fmt or data chunk')

    audio_fmt   = struct.unpack_from('<H', fmt_chunk, 0)[0]
    num_ch      = struct.unpack_from('<H', fmt_chunk, 2)[0]
    sample_rate = struct.unpack_from('<I', fmt_chunk, 4)[0]
    bps         = struct.unpack_from('<H', fmt_chunk, 14)[0]

    # WAVE_FORMAT_EXTENSIBLE — read sub-format GUID's first word.
    if audio_fmt == 0xFFFE and len(fmt_chunk) >= 26:
        audio_fmt = struct.unpack_from('<H', fmt_chunk, 24)[0]

    frame_bytes = (bps // 8) * num_ch

    if audio_fmt == 3 and bps == 32:
        n = len(data_chunk) // frame_bytes
        interleaved = list(struct.unpack_from(f'<{n * num_ch}f', data_chunk))
    elif audio_fmt == 1 and bps == 16:
        n = len(data_chunk) // frame_bytes
        interleaved = [s / 32768.0
                       for s in struct.unpack_from(f'<{n * num_ch}h', data_chunk)]
    elif audio_fmt == 1 and bps == 24:
        n = len(data_chunk) // frame_bytes
        interleaved = [_s24_le(data_chunk, i * 3) / 8388608.0
                       for i in range(n * num_ch)]
    elif audio_fmt == 1 and bps == 32:
        n = len(data_chunk) // frame_bytes
        interleaved = [s / 2147483648.0
                       for s in struct.unpack_from(f'<{n * num_ch}i', data_chunk)]
    else:
        sys.exit(f'error: {path}: unsupported format code {audio_fmt} / {bps}-bit')

    mono = interleaved[::num_ch]  # channel 0 only
    return mono, sample_rate


# ── IR processing pipeline ────────────────────────────────────────────────

def _ir_resample(samples, from_rate, to_rate):
    if from_rate == to_rate:
        return samples
    try:
        from scipy.signal import resample_poly
        from math import gcd
        import numpy as np
        g = gcd(to_rate, from_rate)
        return list(resample_poly(np.array(samples, dtype='float64'),
                                  to_rate // g, from_rate // g))
    except ImportError:
        pass
    try:
        import numpy as np
        n_out = round(len(samples) * to_rate / from_rate)
        return list(np.interp(np.linspace(0, 1, n_out),
                               np.linspace(0, 1, len(samples)),
                               samples))
    except ImportError:
        pass
    n_in = len(samples)
    n_out = round(n_in * to_rate / from_rate)
    result = []
    for i in range(n_out):
        t = i * (n_in - 1) / max(n_out - 1, 1)
        lo = int(t); hi = min(lo + 1, n_in - 1)
        result.append(samples[lo] + (t - lo) * (samples[hi] - samples[lo]))
    return result


def _ir_minimum_phase(samples, eps=1e-8):
    """Minimum-phase conversion via real cepstrum. Requires numpy."""
    import numpy as np
    n = len(samples)
    if n < 4:
        return samples
    fft_size = 1
    while fft_size < n:
        fft_size <<= 1
    fft_size <<= 2  # 4× to prevent cepstral aliasing

    h    = np.array(samples, dtype=np.float64)
    H    = np.fft.rfft(h, n=fft_size)
    mag  = np.abs(H)
    peak = float(np.max(mag))
    if peak < 1e-30:
        return samples

    log_mag  = np.log(np.maximum(mag, eps * peak))
    cepstrum = np.fft.irfft(log_mag, n=fft_size)

    fold = np.zeros(fft_size)
    fold[0]                   = cepstrum[0]
    fold[1:fft_size // 2]     = 2.0 * cepstrum[1:fft_size // 2]
    fold[fft_size // 2]       = cepstrum[fft_size // 2]

    h_mp = np.fft.irfft(np.exp(np.fft.rfft(fold, n=fft_size)), n=fft_size)
    return list(h_mp[:n])


def _ir_trim_taper(samples, n_taps, fade_len=256):
    """Truncate to n_taps with a Hann half-window over the last fade_len samples.

    IRs already within n_taps are kept as they are, not zero-padded: the
    firmware's convolver only spends CPU on the partitions an IR occupies.
    """
    import math as _math
    if len(samples) <= n_taps:
        return list(samples)
    out = list(samples[:n_taps])
    fade_len = min(fade_len, n_taps)
    start = n_taps - fade_len
    for i in range(fade_len):
        t = i / max(fade_len - 1, 1)
        out[start + i] *= 0.5 * (1.0 + _math.cos(_math.pi * t))
    return out


def _ir_normalize(samples):
    peak = max(abs(s) for s in samples)
    if peak < 1e-30:
        return list(samples)
    return [s / peak for s in samples]


def process_ir(samples, sample_rate, target_rate=48000, max_taps=MAX_IR_TAPS):
    """Full IR pipeline: resample → min-phase → truncate+taper → normalize."""
    # Resample
    if sample_rate != target_rate:
        print(f'       resampling {sample_rate} Hz → {target_rate} Hz...')
        samples = _ir_resample(samples, sample_rate, target_rate)

    # Minimum-phase conversion
    try:
        samples = _ir_minimum_phase(samples)
        print(f'       min-phase: applied')
    except ImportError:
        print(f'       min-phase: skipped (pip install numpy for better truncation)')

    # Truncate + Hann tail taper
    n_in = len(samples)
    fade = 256  # ~5 ms: smooths the truncation without sacrificing body
    samples = _ir_trim_taper(samples, max_taps, fade_len=fade)
    if n_in > max_taps:
        print(f'       truncated {n_in} → {max_taps} taps '
              f'({n_in / target_rate * 1000:.1f} ms → {max_taps / target_rate * 1000:.1f} ms), '
              f'Hann tail {fade} samples')

    # Normalize
    peak = max(abs(s) for s in samples)
    if peak > 1e-30:
        samples = _ir_normalize(samples)
        print(f'       normalized: peak was {20 * math.log10(peak):.1f} dBFS → 0.0 dBFS')

    return samples


# ── .nam → .namb conversion via nam2namb ─────────────────────────────────

def find_nam2namb():
    """Locate the nam2namb binary, checking known relative paths then PATH."""
    script_dir = os.path.dirname(os.path.abspath(__file__))
    candidates = [
        os.path.join(script_dir, 'nam2namb'),
        os.path.join(script_dir, '..', 'nam-binary-loader', 'build', 'nam2namb'),
        os.path.join(script_dir, '..', 'nam-binary-loader', 'build_tools', 'nam2namb'),
    ]
    for path in candidates:
        if os.path.isfile(path) and os.access(path, os.X_OK):
            return os.path.normpath(path)
    # Fall back to PATH
    import shutil
    found = shutil.which('nam2namb')
    if found:
        return found
    sys.exit(
        'error: nam2namb binary not found.\n'
        'Build it with: cd nam-binary-loader && cmake -B build_tools -DBUILD_TOOLS=ON && cmake --build build_tools\n'
        'Or place the binary next to pack_models.py.'
    )


def nam_to_namb(path, slim_factor=0.0):
    """Convert a .nam file to .namb bytes using the nam2namb binary."""
    binary = find_nam2namb()
    with tempfile.NamedTemporaryFile(suffix='.namb', delete=False) as tmp:
        tmp_path = tmp.name
    try:
        cmd = [binary, '--slim', str(slim_factor), path, tmp_path]
        result = subprocess.run(cmd, capture_output=True, text=True)
        if result.returncode != 0:
            sys.exit(f'error: nam2namb failed:\n{result.stderr.strip()}')
        if result.stderr:
            # nam2namb prints selection info to stderr — relay it
            for line in result.stderr.strip().splitlines():
                print(f'  {line}')
        return open(tmp_path, 'rb').read()
    finally:
        if os.path.exists(tmp_path):
            os.unlink(tmp_path)


# ── model reader (dispatches on file extension) ───────────────────────────

def read_model(path, slim_factor=0.0):
    """Return .namb bytes from a .namb file, or convert a .nam file first."""
    if path.endswith('.nam'):
        return nam_to_namb(path, slim_factor)
    # .namb — read and validate magic
    try:
        data = open(path, 'rb').read()
    except OSError as e:
        sys.exit(f'error: {e}')
    if len(data) < 4:
        sys.exit(f'error: {path}: file too small')
    magic, = struct.unpack_from('<I', data, 0)
    if magic != NAMB_MAGIC:
        sys.exit(f'error: {path}: not a .namb file (magic=0x{magic:08X})')
    return data


# ── Bundle builder ────────────────────────────────────────────────────────

def build_bank(presets):
    """Pack presets into a binary bank.

    presets: list of (name: str, namb: bytes, namb2: bytes | None, ir: bytes | None,
                      nam_model_id: int, block2_model_id: int)
             namb2 (second capture) and ir are mutually exclusive.  The model
             ids are TONE3000 ids for the app's "Sync from pedal" (0 = unknown).
    Returns: bytes
    """
    n = len(presets)
    cur = HEADER_SIZE + n * ENTRY_SIZE

    # Lay out the blobs in order (namb, namb2, ir per preset), 4-byte aligned.
    # offsets[i] = (namb_offset, namb2_offset, ir_offset), 0 where absent.
    offsets = []
    blobs = b''
    for _name, namb, namb2, ir, _id1, _id2 in presets:
        row = []
        for blob in (namb, namb2, ir):
            if blob is None or len(blob) == 0:
                row.append(0)
                continue
            row.append(cur)
            pad = (4 - len(blob) % 4) % 4
            blobs += blob + b'\x00' * pad
            cur += len(blob) + pad
        offsets.append(row)

    # Header: magic(4) version(4) num_presets(4) + padding to 64 bytes.
    hdr = struct.pack('<III', BANK_MAGIC, BANK_VERSION, n).ljust(HEADER_SIZE, b'\x00')

    # Entries: name(32) nam_offset nam_size nam2_offset nam2_size ir_offset
    # ir_num_samples nam_model_id block2_model_id.
    entries = b''
    for (name, namb, namb2, ir, id1, id2), (off1, off2, off_ir) in zip(presets, offsets):
        name_b = name.encode('ascii', errors='replace')[:31].ljust(32, b'\x00')
        entries += name_b + struct.pack('<IIIIIIII',
                                       off1,   len(namb),
                                       off2,   len(namb2) if namb2 else 0,
                                       off_ir, len(ir) // 4 if ir else 0,
                                       id1 & 0xFFFFFFFF, id2 & 0xFFFFFFFF)
    assert len(entries) == n * ENTRY_SIZE

    return hdr + entries + blobs


# ── Bank inspector ────────────────────────────────────────────────────────

def list_bank(path):
    try:
        raw = open(path, 'rb').read()
    except OSError as e:
        sys.exit(f'error: {e}')
    if len(raw) < HEADER_SIZE:
        sys.exit('error: file too small to be a model bank')
    magic, version, n = struct.unpack_from('<III', raw, 0)
    if magic != BANK_MAGIC:
        sys.exit(f'error: not a preset bank (magic=0x{magic:08X})')
    if version != BANK_VERSION:
        sys.exit(f'error: bank version {version}, this tool reads version {BANK_VERSION}')
    print(f'Preset bank v{version}: {n} preset(s), {len(raw)} bytes total')
    model = lambda mid: f' (model {mid})' if mid else ''
    for i in range(n):
        base = HEADER_SIZE + i * ENTRY_SIZE
        name = raw[base:base + 32].split(b'\x00')[0].decode('ascii', errors='replace')
        _, nam_sz, _, nam2_sz, _, ir_num, id1, id2 = struct.unpack_from('<IIIIIIII', raw, base + 32)
        if nam_sz == 0:
            print(f'  [{i + 1}] (empty)')
            continue
        if nam2_sz:
            block2 = f'NAM {nam2_sz} B{model(id2)}'
        elif ir_num:
            block2 = f'IR {ir_num} taps ({ir_num / 48.0:.1f} ms){model(id2)}'
        else:
            block2 = 'none'
        print(f'  [{i + 1}] "{name}"  NAM {nam_sz} B{model(id1)}  block 2: {block2}')


def dump_pedal(port, timeout=3.0):
    """Ask the running firmware ('B') for its bank directory and print it."""
    try:
        import serial
    except ImportError:
        sys.exit('error: pyserial is required for --port  (pip install pyserial)')
    try:
        s = serial.Serial(port, baudrate=115200, timeout=0.2)
    except Exception as e:
        sys.exit(f'error: could not open {port}: {e}')
    with s:
        s.dtr = True
        time.sleep(0.2)
        s.reset_input_buffer()
        s.write(b'B')
        s.flush()
        buf = b''
        deadline = time.monotonic() + timeout
        while b'T3K-BANK-END' not in buf and time.monotonic() < deadline:
            buf += s.read(512)
    text = buf.decode('ascii', errors='replace')
    begin, end = text.find('T3K-BANK-BEGIN'), text.find('T3K-BANK-END')
    if begin < 0 or end < 0:
        sys.exit("error: no reply from the pedal; its firmware needs the 'B' command "
                 '(rebuild and reflash from this repo)')
    for line in text[begin + len('T3K-BANK-BEGIN'):end].splitlines():
        if line.strip():
            print(line.strip())


# ── Flasher ───────────────────────────────────────────────────────────────

def trigger_dfu(port):
    """Send the DFU trigger byte ('D') to the pedal over USB CDC."""
    try:
        import serial
    except ImportError:
        sys.exit('error: pyserial is required for --port  (pip install pyserial)')

    print(f'sending DFU trigger to {port}...')
    try:
        s = serial.Serial(port, baudrate=115200, timeout=1)
        s.dtr = True      # macOS USB CDC requires DTR asserted to forward data
        time.sleep(0.2)   # let the CDC connection settle before writing
        s.write(b'D')
        s.flush()         # ensure the USB packet is transmitted before close
        time.sleep(0.5)   # keep the port open until the packet is on the wire
        s.close()
    except Exception as e:
        sys.exit(f'error: could not open {port}: {e}')


def flash(path, addr, dfu_timeout=15.0):
    # pydfu.py (MIT) is vendored alongside this script; requires pyusb (BSD).
    sys.path.insert(0, os.path.dirname(os.path.abspath(__file__)))
    import pydfu

    data = open(path, 'rb').read()
    print('waiting for Daisy DFU device (0483:df11)...', end='', flush=True)
    deadline = time.monotonic() + dfu_timeout
    while True:
        try:
            pydfu.init(idVendor=0x0483, idProduct=0xdf11)
            print(' connected')
            break
        except ValueError:
            if time.monotonic() >= deadline:
                print()
                sys.exit(
                    f'error: DFU device not found after {dfu_timeout:.0f} s\n'
                    f'(use --port /dev/tty.usbmodemXXXX to trigger DFU automatically,\n'
                    f' or put the Daisy into DFU mode manually before flashing)')
            print('.', end='', flush=True)
            time.sleep(0.5)

    elements = [{'addr': addr, 'size': len(data), 'data': bytearray(data)}]
    pydfu.write_elements(elements, mass_erase_used=False, progress=pydfu.cli_progress)
    pydfu.exit_dfu()
    print('flash complete')


# ── CLI ───────────────────────────────────────────────────────────────────

def main():
    p = argparse.ArgumentParser(description=__doc__,
                                formatter_class=argparse.RawDescriptionHelpFormatter)
    p.add_argument('presets', nargs='*', metavar='NAME:NAM[:NAM2|IR]')
    p.add_argument('-o', '--output', default='model_bank.bin', metavar='FILE')
    p.add_argument('--slim', type=float, default=0.0, metavar='FLOAT',
                   help='slim factor for SlimmableContainer .nam files (default: 0.0)')
    p.add_argument('--flash', action='store_true',
                   help='flash to Daisy via pydfu after building')
    p.add_argument('--port', metavar='PORT',
                   help='serial port of the running pedal; triggers DFU automatically')
    p.add_argument('--addr', default=0x90600000,
                   type=lambda x: int(x, 16), metavar='ADDR',
                   help='target flash address in hex (default: 0x90600000)')
    p.add_argument('--list', metavar='FILE',
                   help='list presets in an existing bank and exit')
    p.add_argument('--dump', action='store_true',
                   help='print the bank directory of the pedal on --port and exit')
    args = p.parse_args()

    if args.list:
        list_bank(os.path.expanduser(args.list))
        return
    if args.dump:
        if not args.port:
            sys.exit('error: --dump needs --port /dev/tty.usbmodemXXXX')
        dump_pedal(args.port)
        return

    if not args.presets:
        p.print_help()
        sys.exit(1)

    def split_id(part):
        """'path@ID' -> (path, ID); plain 'path' -> (path, 0)."""
        path, sep, mid = part.rpartition('@')
        if sep and mid.isdigit():
            return os.path.expanduser(path), int(mid)
        return os.path.expanduser(part), 0

    presets = []
    for spec in args.presets:
        parts = spec.split(':')
        if len(parts) < 2 or len(parts) > 3:
            sys.exit(f"error: expected NAME:NAM[:NAM2|IR], got '{spec}'")
        name = parts[0].strip()
        if not name:
            sys.exit(f"error: empty name in '{spec}'")

        model_path, id1 = split_id(parts[1])
        namb = read_model(model_path, slim_factor=args.slim)
        print(f'  [{len(presets) + 1}] {name}: {model_path} ({len(namb)} bytes)'
              + (f'  model {id1}' if id1 else ''))

        # Block 2: a second capture or a cabinet IR, told apart by extension.
        namb2 = ir_bytes = None
        id2 = 0
        if len(parts) == 3:
            path2, id2 = split_id(parts[2])
            if path2.lower().endswith('.wav'):
                ir_samples, sr = read_wav_mono_f32(path2)
                print(f'       IR: {path2} ({len(ir_samples)} taps @ {sr} Hz)')
                ir_samples = process_ir(ir_samples, sr)
                ir_bytes = struct.pack(f'<{len(ir_samples)}f', *ir_samples)
            else:
                namb2 = read_model(path2, slim_factor=args.slim)
                print(f'       NAM 2: {path2} ({len(namb2)} bytes)')
            if id2:
                print(f'       model {id2}')

        presets.append((name, namb, namb2, ir_bytes, id1, id2))

    bank = build_bank(presets)
    output_path = os.path.expanduser(args.output)
    with open(output_path, 'wb') as f:
        f.write(bank)
    print(f'wrote {len(bank)} bytes → {output_path}  '
          f'({len(presets)} preset(s) at 0x{args.addr:08X})')

    if args.flash:
        if args.port:
            trigger_dfu(args.port)
        flash(output_path, args.addr)


if __name__ == '__main__':
    main()
