tone-3000/nam-pedal/(commit log)

2026-10-17 Add hardware: KiCad project, Gerbers, BOM, enclosure drill/print files, 3D models, renders
    - hardware/pcb: KiCad 10 project with project libraries and STEP models, Gerber X2 + Excellon
    exports, schematic PDF/SVG, BOM (with Tayda links) and KiCad BOM, board images
    - hardware/enclosure: 1590XX face artwork + drill template (AI master, 1:1 PDFs), side wordmark,
    Tayda drill-service file, parametric CadQuery enclosure model
    - hardware/3d: glTF of the finished pedal and the populated PCB
    - hardware/renders: pedal/build/PCB-stage renders, 36 s build animation, Blender/CadQuery sources
    - README: hardware section with renders and build animation
2026-10-19 diy pedal kit sprint... pcb, renders, bom, rename syntax, calibration, normalization, sync from pedal, embedded and libdaisy as submodules, 2 a2 lite
2026-10-20 Cab IR: daisyConvol partitioned convolution, 4096 taps
    Replace the 256-tap time-domain FIR with VZtec/daisyConvol (MIT, git
    submodule pinned to v0.1.0), a zero-latency non-uniform partitioned FFT
    convolver on CMSIS-DSP.
    - Engine runs 16-sample blocks, three per 48-frame callback; geometry
    16x16 + 30x128 for a 4096-sample IR, all in the callback. Fast arena
    and FFT tables in DTCM, 60 KB medium arena in AXI SRAM.
    - Engine and CMSIS FFT kernels linked into ITCM next to NAM. The ITCM
    copy now runs from .preinit_array, before C++ static initializers,
    since the FFT backend's initializer lives in ITCM too.
    - conv_engine.o built with -fno-fast-math to keep its NaN/inf guards.
    - IR gain stag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
